shaliulab/idoc_docs/README.md

IDOC DOCS

To spawn the docs locally:

```
mkdocs serve
```

# In Ubuntu Linux, if you don't have mkdocs

```
sudo apt install mkdocs
```
