shaliulab/idoc_docs/docs/assets/src/Design_Files_LED_Driver_.01/README.md

LED_Driver V.01 

Currently, we have not shared the LED-driver designs, but please get in contact if you need further information.
