shaliulab/idoc_docs/docs/assets/src/ElectricShock/README.md

Currently, we have not shared the electric shock grid designs on the transparent induim tin oxid (ITO) glass slides, but please get in contact if you need further information.
