shaliulab/idoc_docs/docs/assets/Images/20220316_103206.jpg

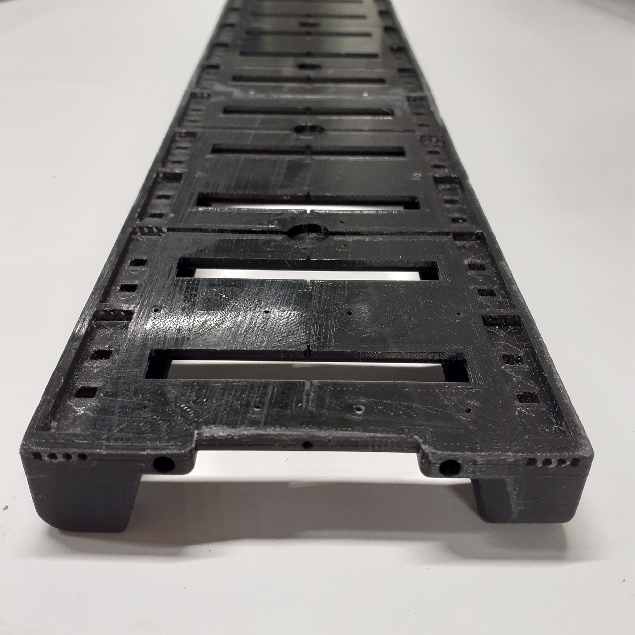
docs/assets/Images/20220316_103206.jpg
