shaliulab/idoc_docs/docs/assets/Images/20220316_135914.jpg

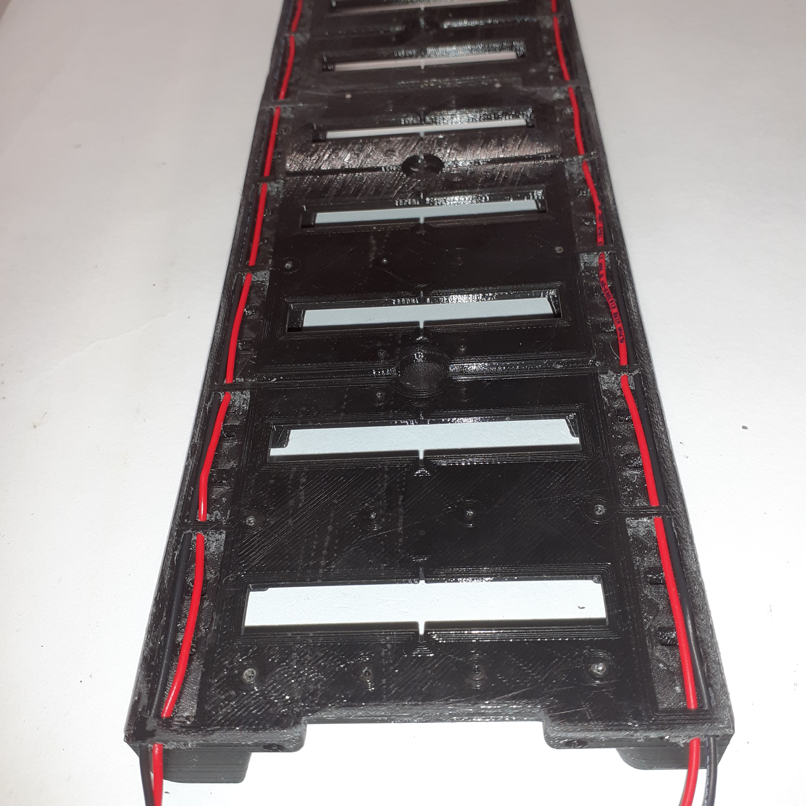
docs/assets/Images/20220316_135914.jpg
