shaliulab/idoc_docs/docs/assets/Images/20220321_164638.jpg

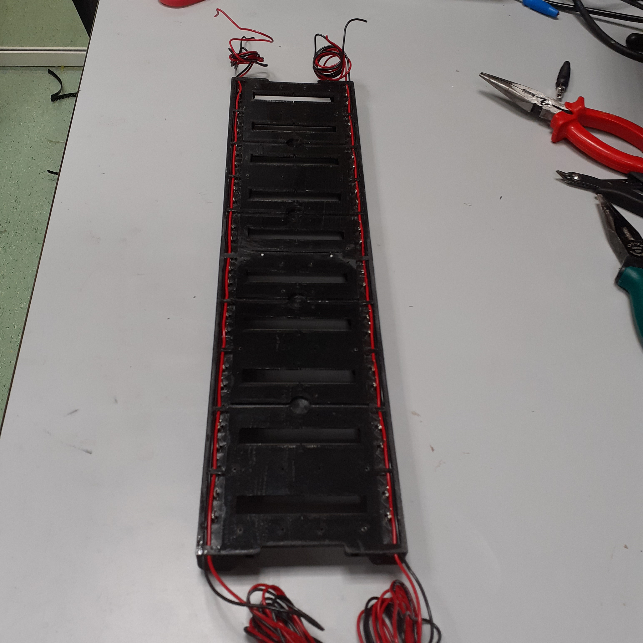
docs/assets/Images/20220321_164638.jpg
