shaliulab/idoc_docs/docs/assets/Images/chamber-tray-real.jpg

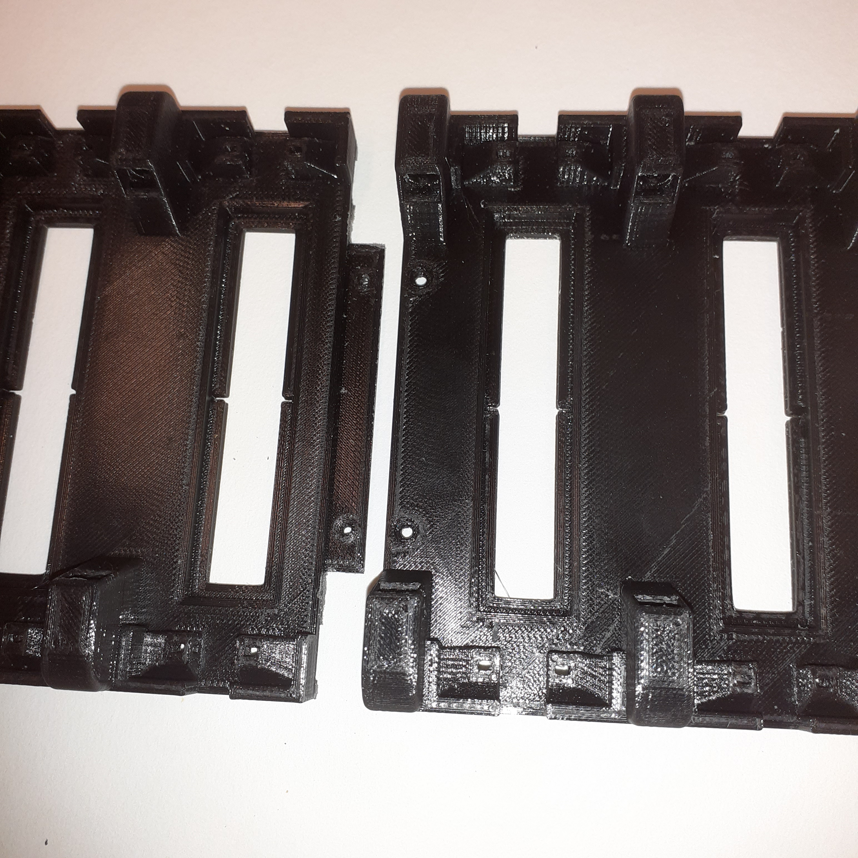
docs/assets/Images/chamber-tray-real.jpg
