shaliulab/idoc_docs/docs/assets/Images/chamber-tray-superglue.jpg

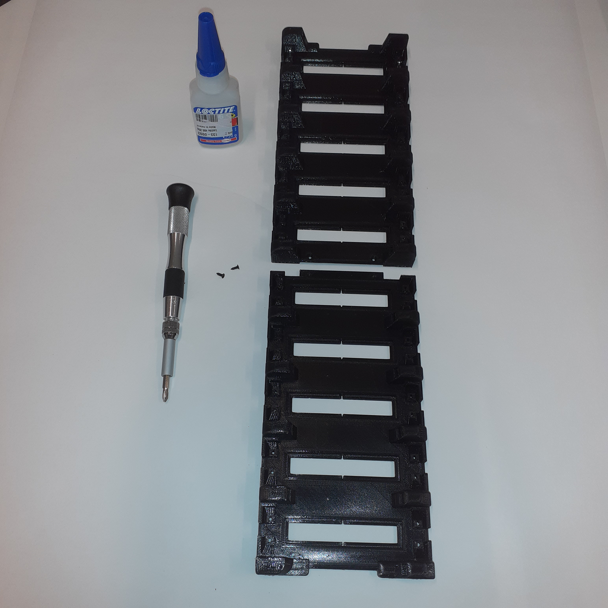
docs/assets/Images/chamber-tray-superglue.jpg
