shaliulab/idoc_docs/docs/assets/Images/idoc_cli-menu.jpg

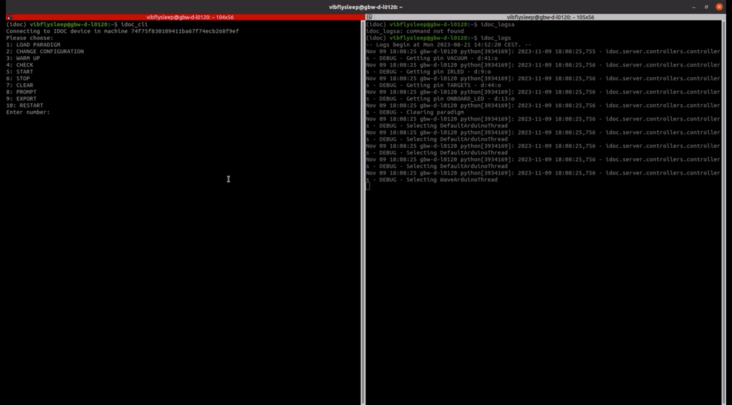
docs/assets/Images/idoc_cli-menu.jpg
