shaliulab/idoc_docs/docs/assets/Images/tracking_dots_annotated.png

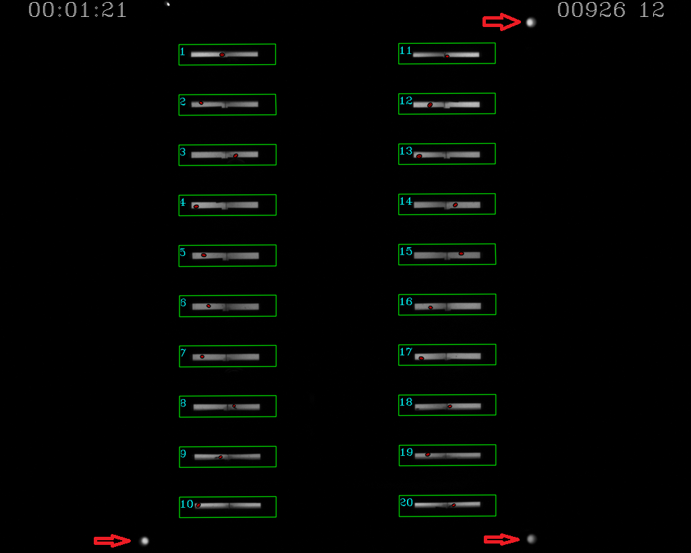
docs/assets/Images/tracking_dots_annotated.png
