shaliulab/idoc_docs/docs/assets/src/3D_printed_parts/Recording_chambers/README.md

Currently, we have not shared the chamber 3D-designs, but please get in contact if you need further information.

We have developed the following designs:

- Chamber_with- ITO_glass --> to provide the electric shocks during training.
- Chamber_ Non ITO_glass--> to be used for pre- and post- conditioning  testing.
- Chamber_Heater_glass --> to provide an increase in the temperature while testing.
- Chamber_saving_rack.

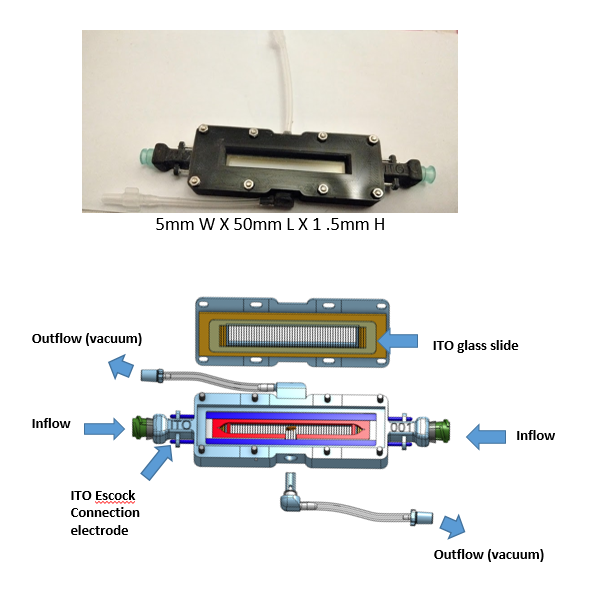
[picture p9: docs/assets/Images/IDOC-Chamber.PNG]
