shaliulab/idoc_docs/docs/IDOC_3D_Assembly_Parts.pdf

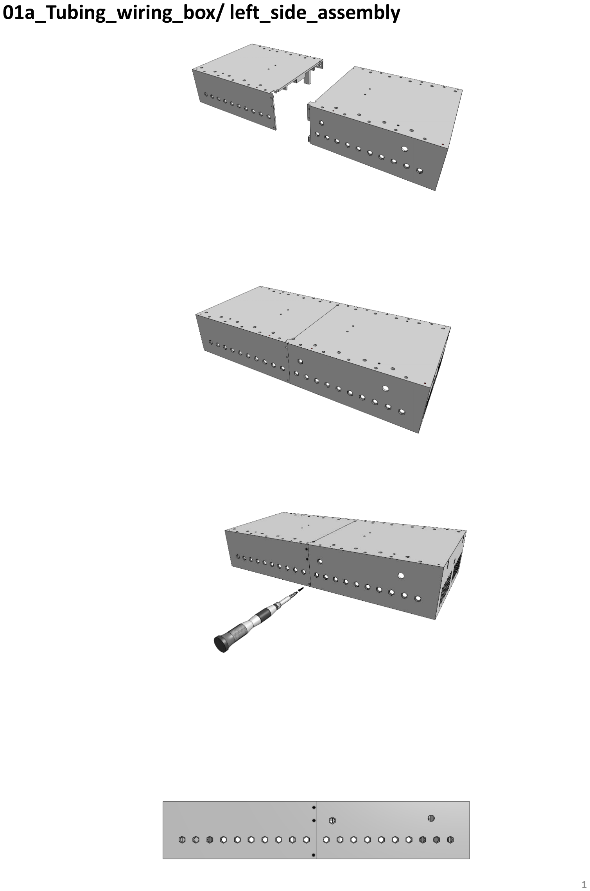
[picture p121: page 1]

01a_Tubing_wiring_box/ left_side_assembly

1

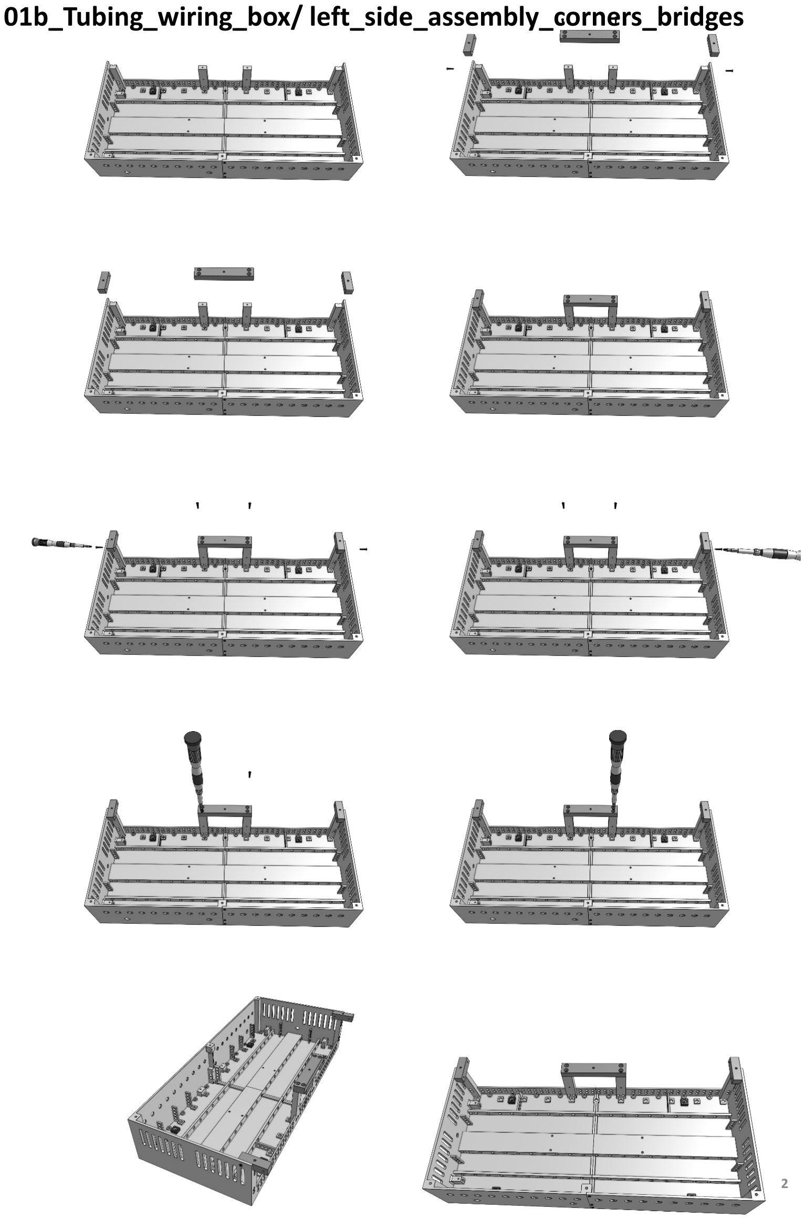
[picture p122: page 2]

01b_Tubing_wiring_box/ left_side_assembly_corners_bridges

2

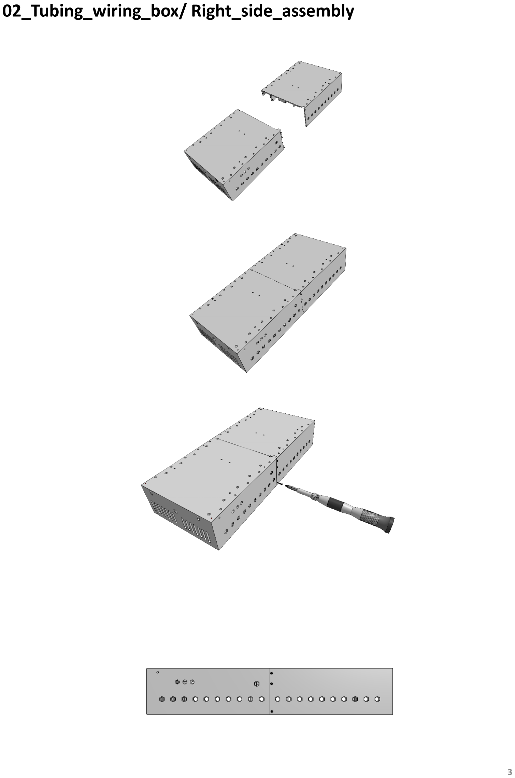
[picture p123: page 3]

02_Tubing_wiring_box/ Right_side_assembly

3

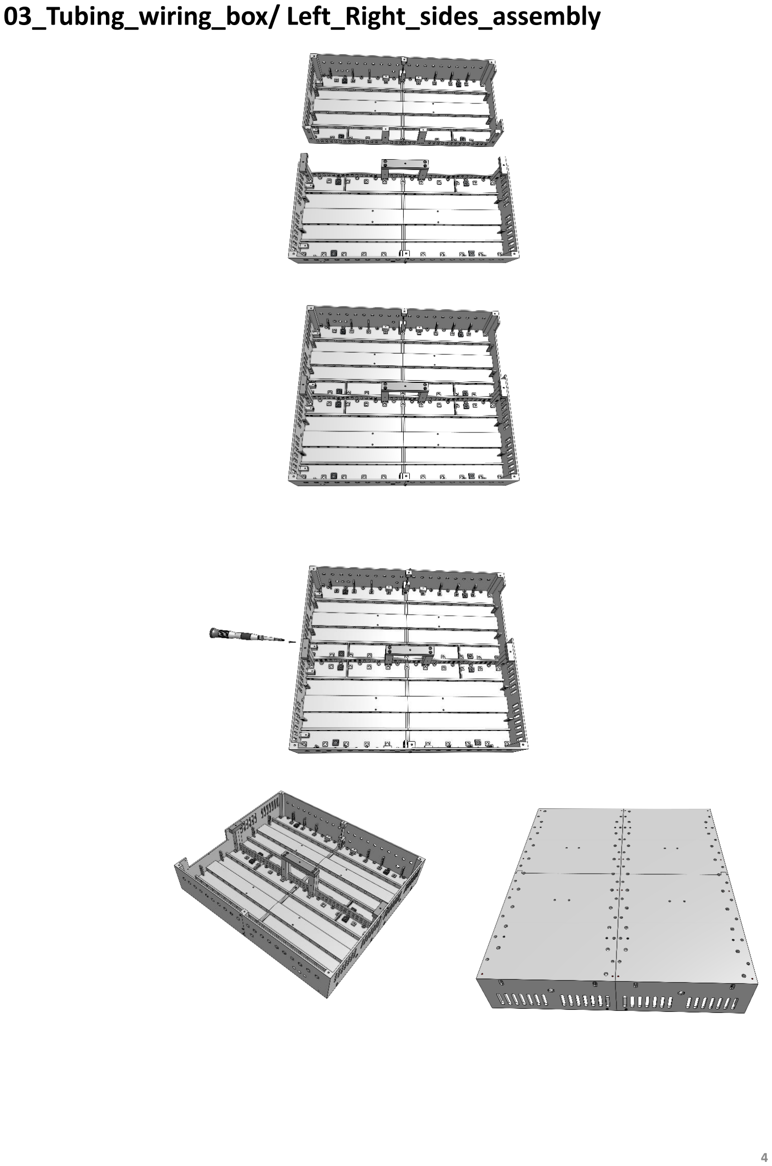
[picture p124: page 4]

03_Tubing_wiring_box/ Left_Right_sides_assembly

4

04a_Inflow_tubings_collectors_Right&Left

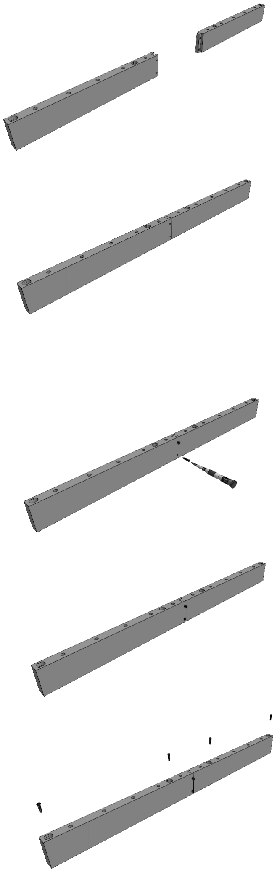
[picture p125: figure]

5

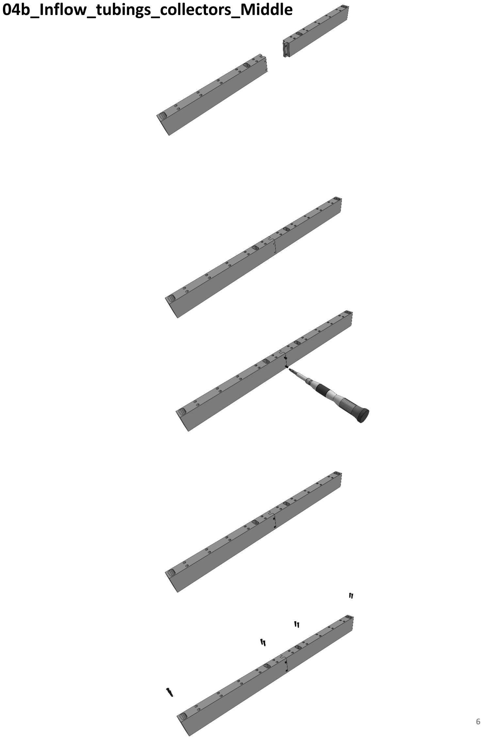
[picture p126: page 6]

04b_Inflow_tubings_collectors_Middle

6

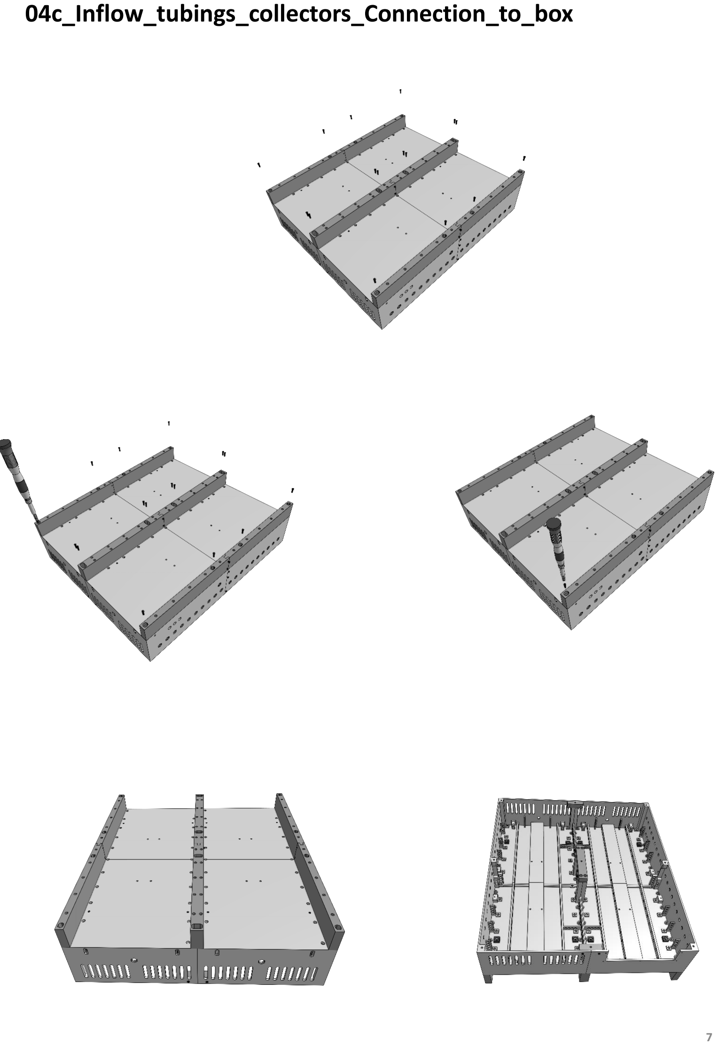
[picture p127: page 7]

04c_Inflow_tubings_collectors_Connection_to_box

7

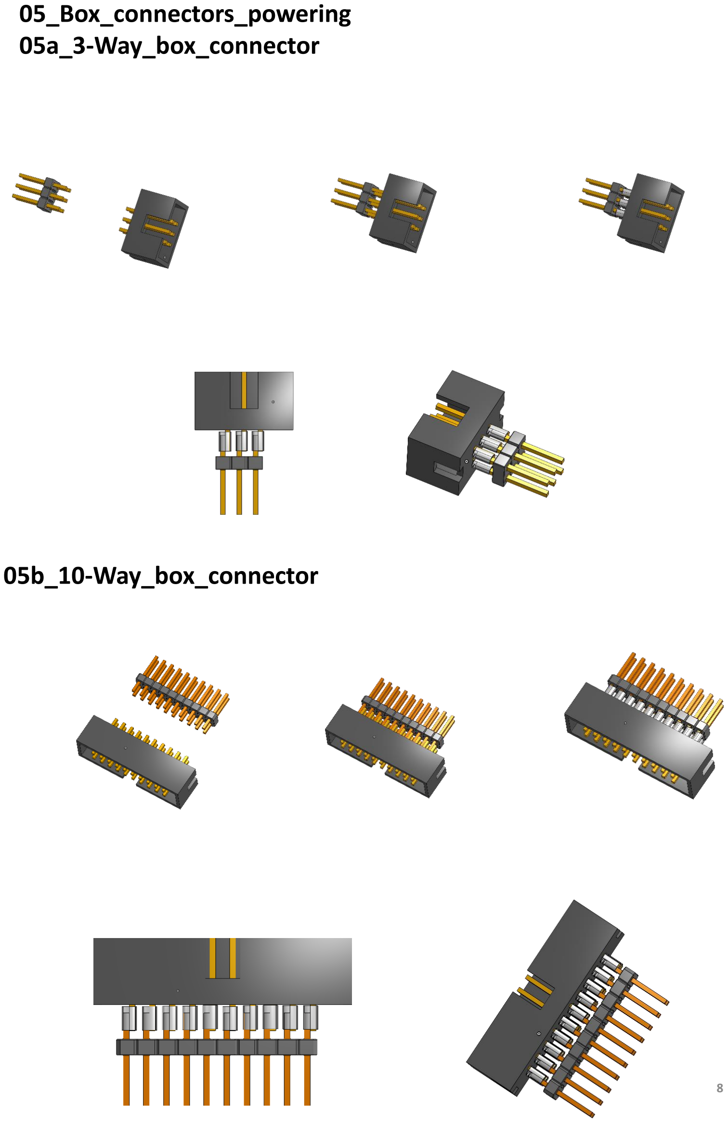
[picture p128: page 8]

05_Box_connectors_powering 05a_3-Way_box_connector

05b_10-Way_box_connector

8

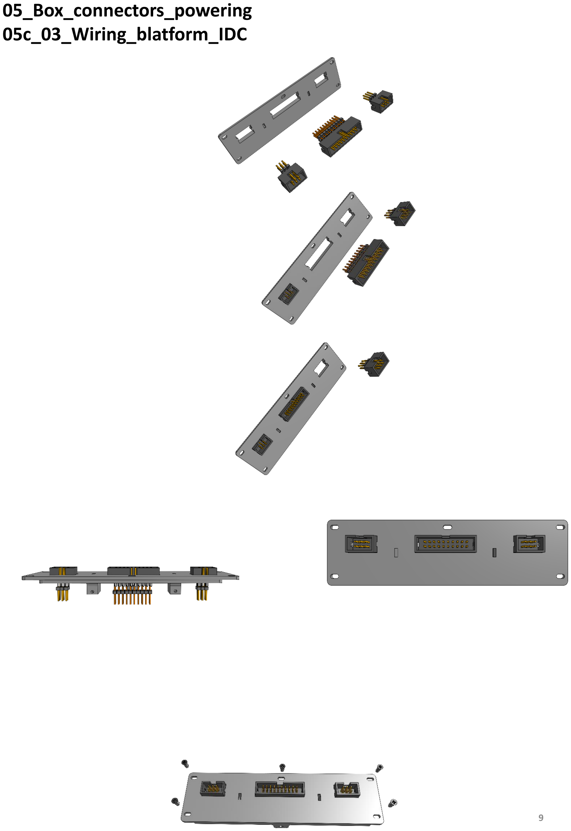
[picture p129: page 9]

05_Box_connectors_powering 05c_03_Wiring_blatform_IDC

9

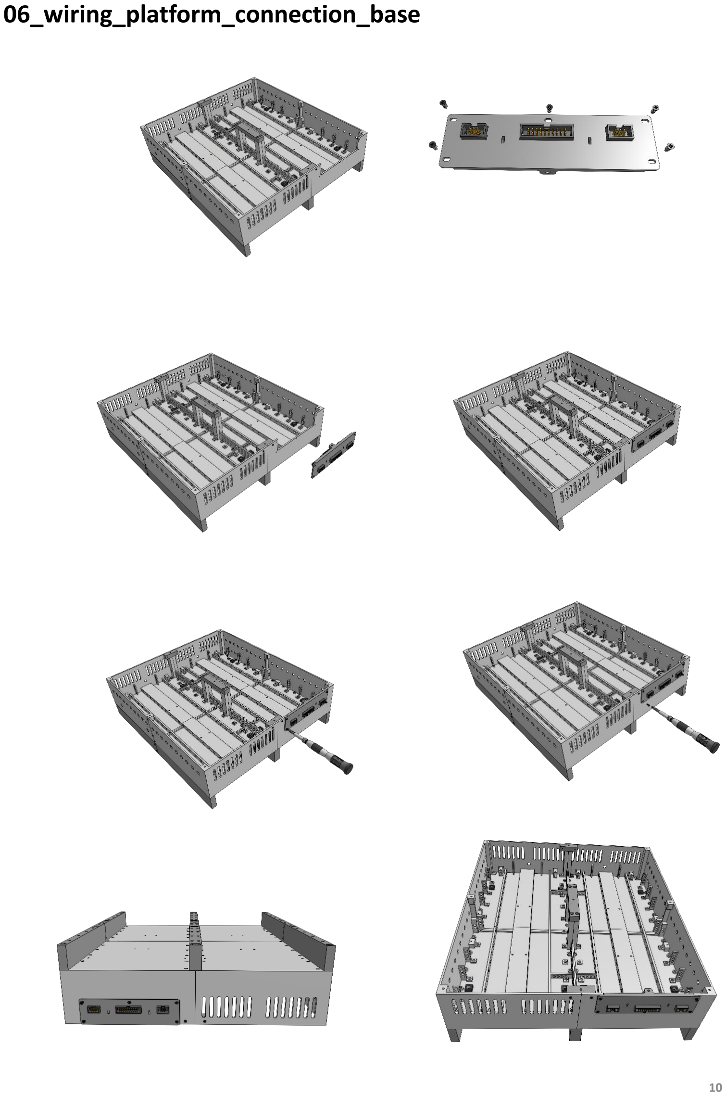
[picture p130: page 10]

06_wiring_platform_connection_base

10

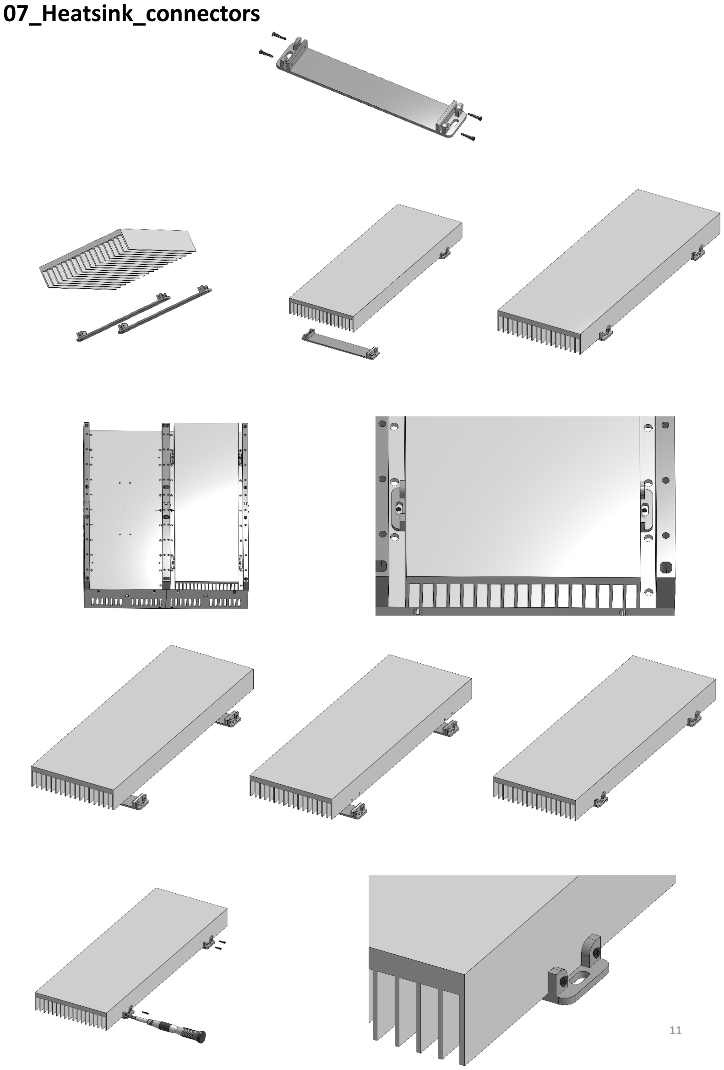
[picture p131: page 11]

07_Heatsink_connectors

11

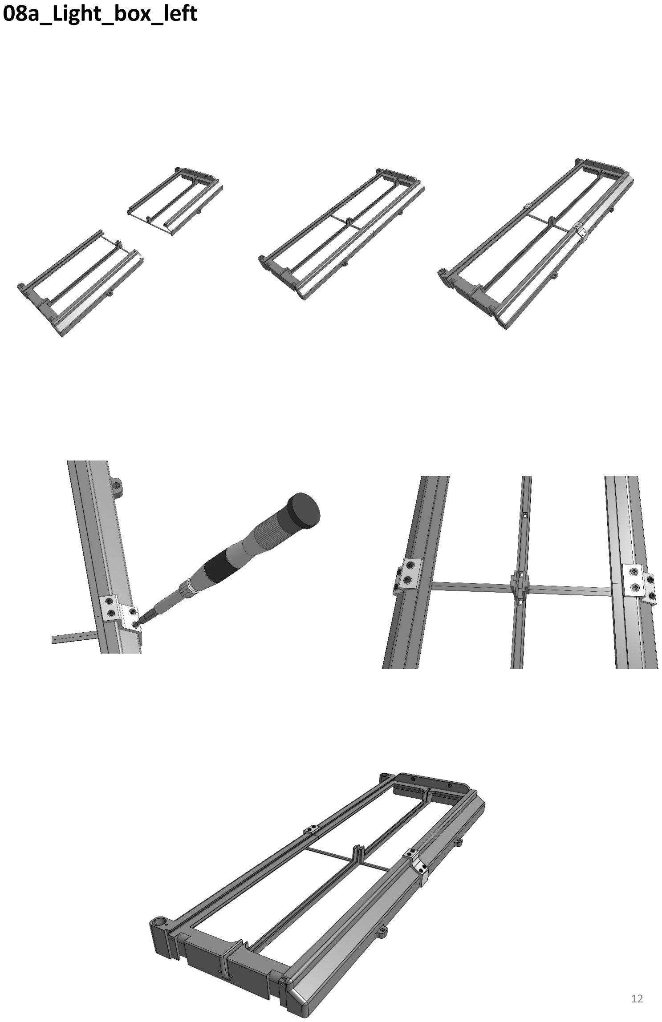
[picture p132: page 12]

08a_Light_box_left

12

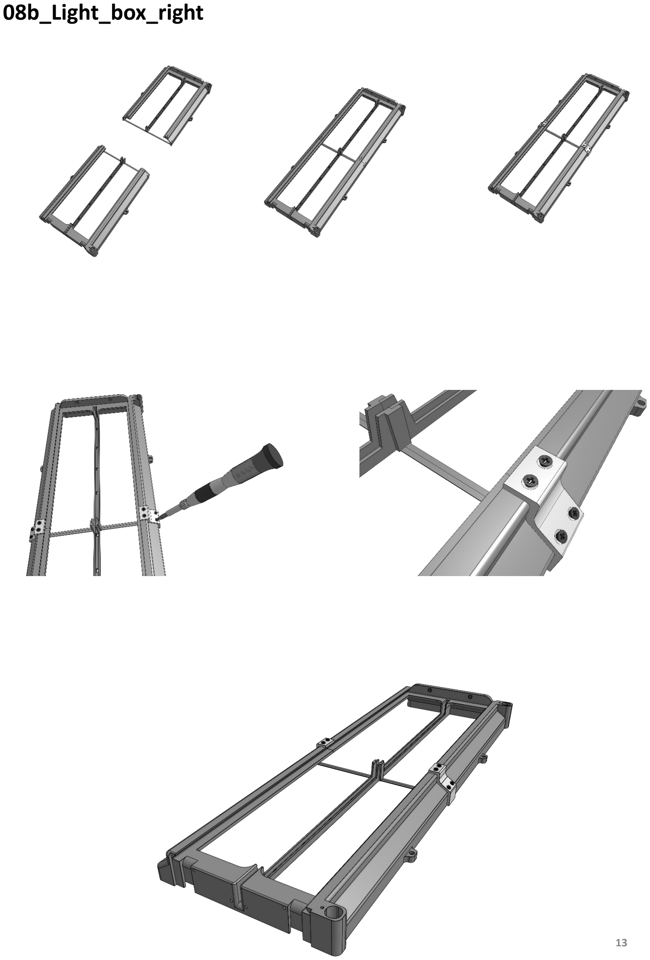
[picture p133: page 13]

08b_Light_box_right

13

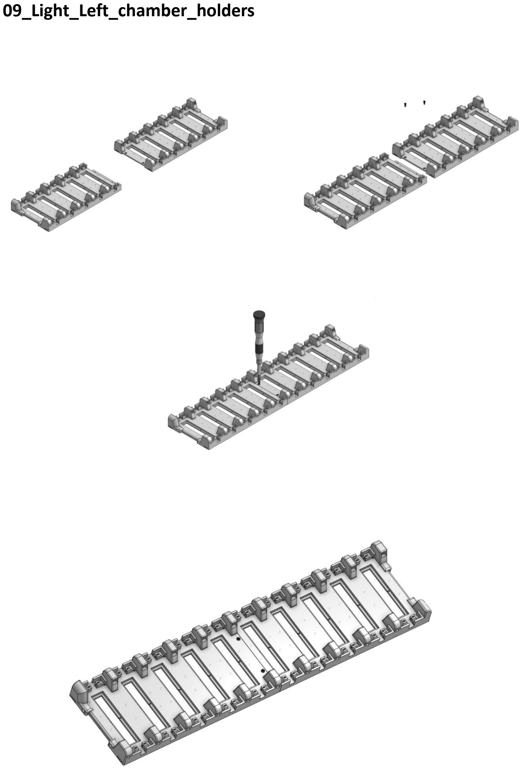
[picture p134: page 14]

09_Light_Left_chamber_holders
