shaliulab/idoc_docs/docs/assets/src/3D_printed_parts/Air_inflow_outflow_olfaction_system/main valve holder - Main_valve_holder.stl

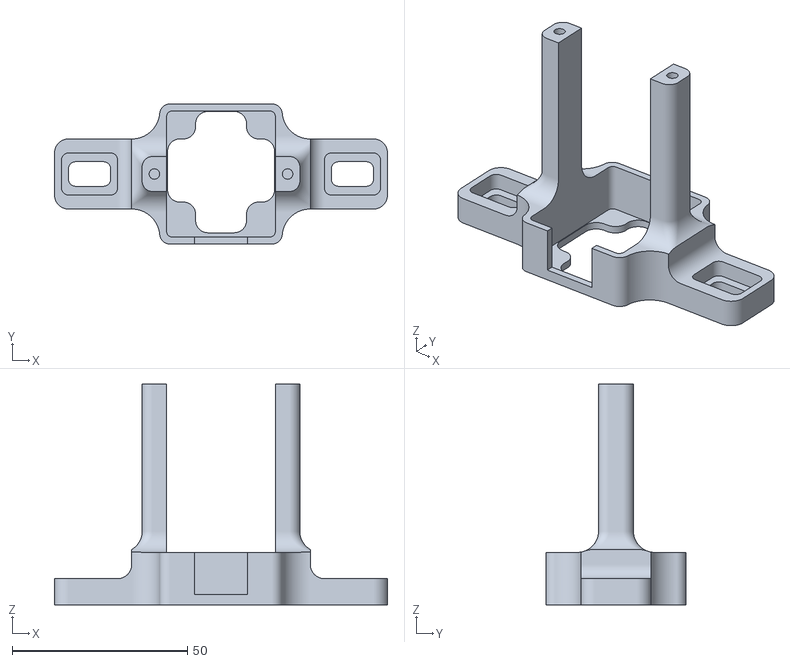
[picture p135: CAD file, 2022-08-08]
docs/assets/src/3D_printed_parts/Air_inflow_outflow_olfaction_system/main valve holder - Main_valve_holder.stl
95.0 x 40.0 x 63.0
