shaliulab/idoc_docs/docs/assets/src/3D_printed_parts/Air_inflow_outflow_olfaction_system/main valve holder - Valve_Locker.stl

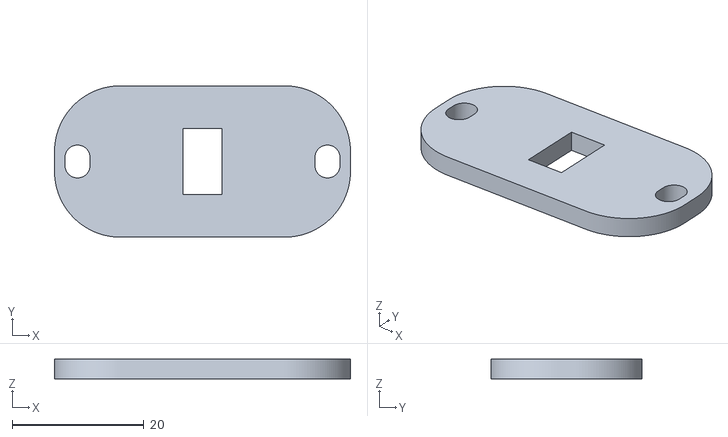
[picture p136: CAD file, 2022-08-08]
docs/assets/src/3D_printed_parts/Air_inflow_outflow_olfaction_system/main valve holder - Valve_Locker.stl
45.0 x 23.0 x 3.00
