shaliulab/idoc_docs/docs/assets/src/3D_printed_parts/100ml-mineral-oil-bottle-holders/100 ml bottle holders Bottom - white_background.stl

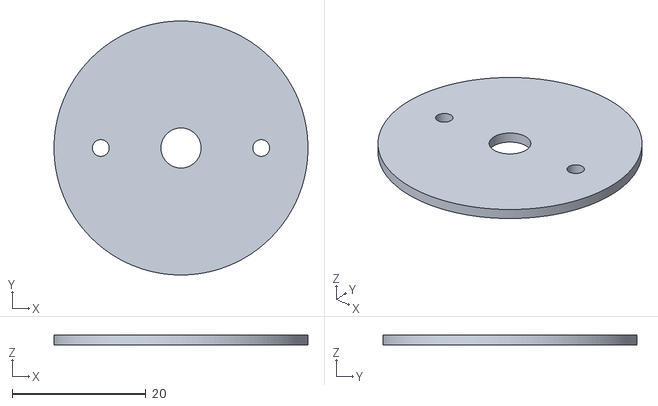
[picture p137: CAD file, 2022-08-08]
docs/assets/src/3D_printed_parts/100ml-mineral-oil-bottle-holders/100 ml bottle holders Bottom - white_background.stl
38.0 x 38.0 x 1.50
