shaliulab/idoc_docs/docs/assets/src/3D_printed_parts/Air_inflow_outflow_olfaction_system/tubes collection.stl

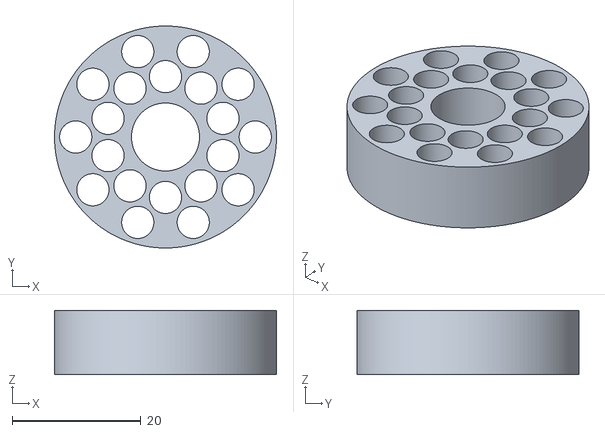
[picture p138: CAD file, 2022-08-08]
docs/assets/src/3D_printed_parts/Air_inflow_outflow_olfaction_system/tubes collection.stl
34.5 x 34.5 x 10.0
