shaliulab/idoc_docs/docs/assets/src/3D_printed_parts/Arduion-control-unit/Arduino_relay_board_BACK.stl

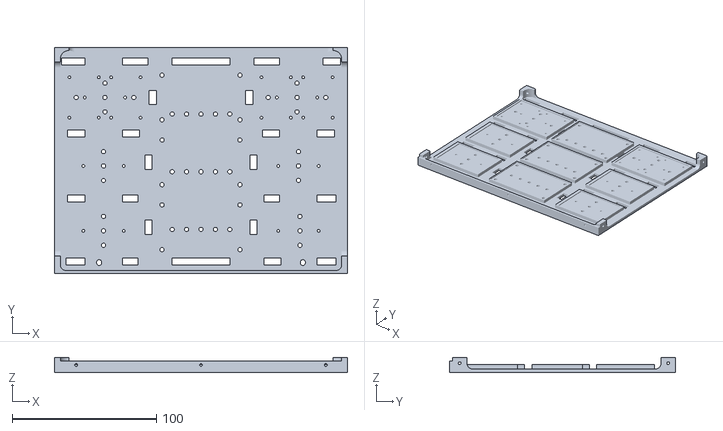
[picture p139: CAD file, 2022-08-08]
docs/assets/src/3D_printed_parts/Arduion-control-unit/Arduino_relay_board_BACK.stl
203.2 x 156.6 x 10.5
