shaliulab/idoc_docs/docs/assets/src/3D_printed_parts/Enclosure&Powering/25-mm_mounting_constructions/Elbow_L-shape_door_connection.stl

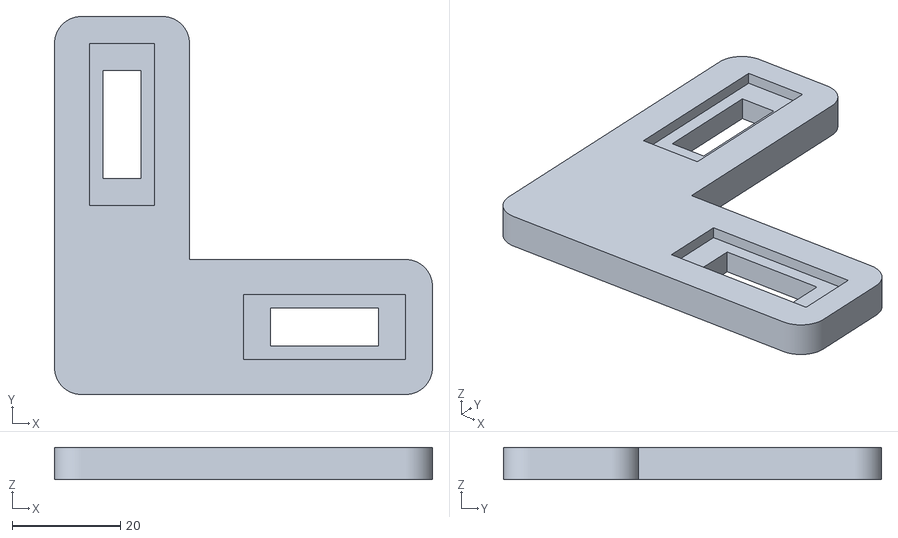
[picture p140: CAD file, 2022-08-08]
docs/assets/src/3D_printed_parts/Enclosure&Powering/25-mm_mounting_constructions/Elbow_L-shape_door_connection.stl
70.0 x 70.0 x 6.00
