shaliulab/idoc_docs/docs/assets/src/3D_printed_parts/Enclosure&Powering/Holes_backside_enclosure/Powering_panels/Bottom_left_panel/Outside_box_cover_bottom_powering_panel_part_3_of_3.stl

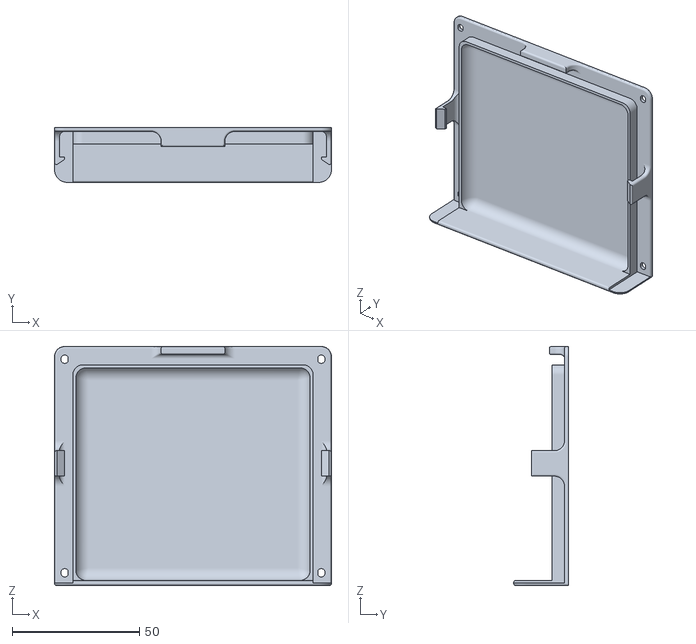
[picture p141: CAD file, 2022-08-08]
docs/assets/src/3D_printed_parts/Enclosure&Powering/Holes_backside_enclosure/Powering_panels/Bottom_left_panel/Outside_box_cover_bottom_powering_panel_part_3_of_3.stl
108.8 x 21.5 x 93.9
