shaliulab/idoc_docs/docs/assets/src/3D_printed_parts/Enclosure&Powering/Holes_backside_enclosure/Powering_panels/Top_right_and_left_panel/IDC_CONNECTOR_GREEN_LEDs_top_powering_panel_part_1_of_3.stl

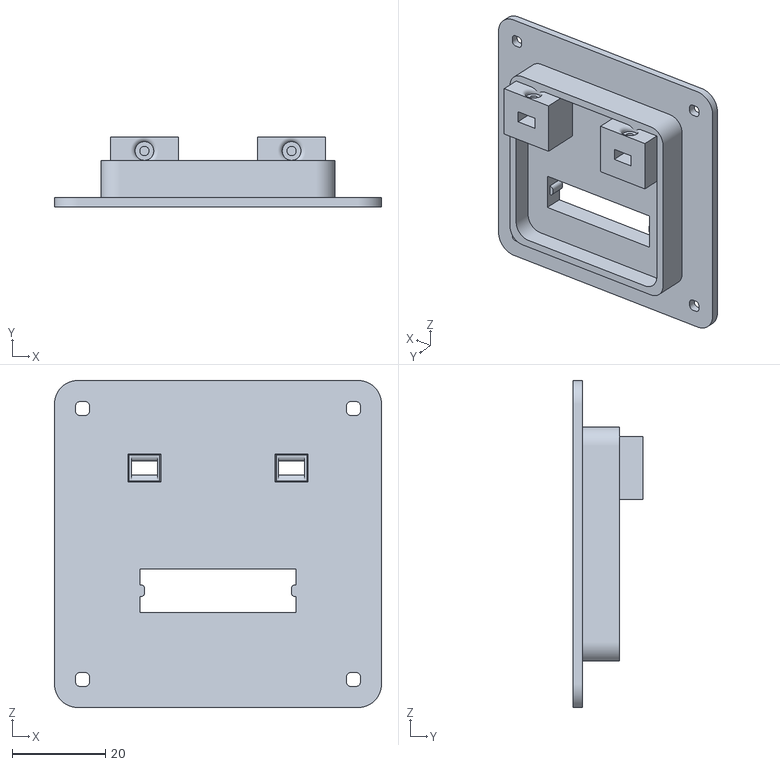
[picture p142: CAD file, 2022-08-08]
docs/assets/src/3D_printed_parts/Enclosure&Powering/Holes_backside_enclosure/Powering_panels/Top_right_and_left_panel/IDC_CONNECTOR_GREEN_LEDs_top_powering_panel_part_1_of_3.stl
70.0 x 15.0 x 70.0
