shaliulab/idoc_docs/docs/assets/src/3D_printed_parts/Enclosure&Powering/Roof_IR_Sheet_holder/IR_sheet_holder_roof_fixation_LED_light_stripe_inside_part_1_of_2.stl

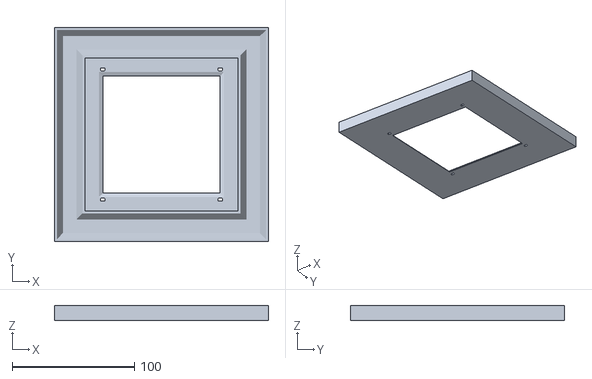
[picture p143: CAD file, 2022-08-08]
docs/assets/src/3D_printed_parts/Enclosure&Powering/Roof_IR_Sheet_holder/IR_sheet_holder_roof_fixation_LED_light_stripe_inside_part_1_of_2.stl
175.0 x 175.0 x 12.0
