shaliulab/idoc_docs/docs/assets/src/3D_printed_parts/Enclosure&Powering/Two_side_connection_IDC_cables/two_side_connection - cover.stl

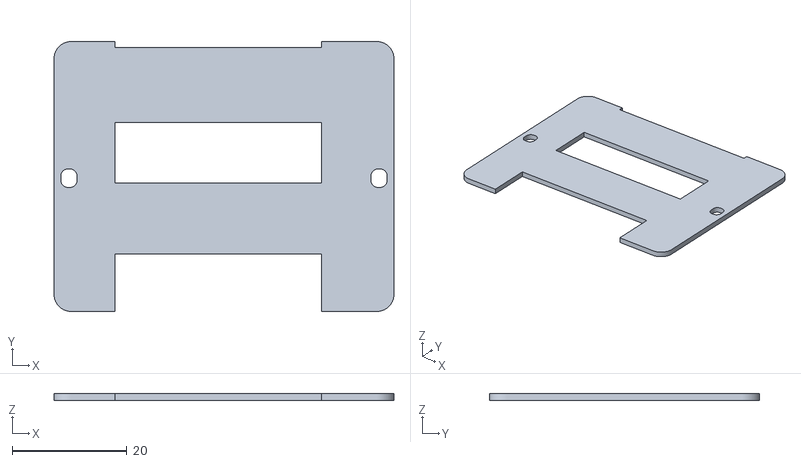
[picture p144: CAD file, 2022-08-08]
docs/assets/src/3D_printed_parts/Enclosure&Powering/Two_side_connection_IDC_cables/two_side_connection - cover.stl
59.2 x 47.0 x 1.20
