shaliulab/idoc_docs/docs/assets/src/3D_printed_parts/Green_light_panel/Green_light_panel - Heat_sink.stl

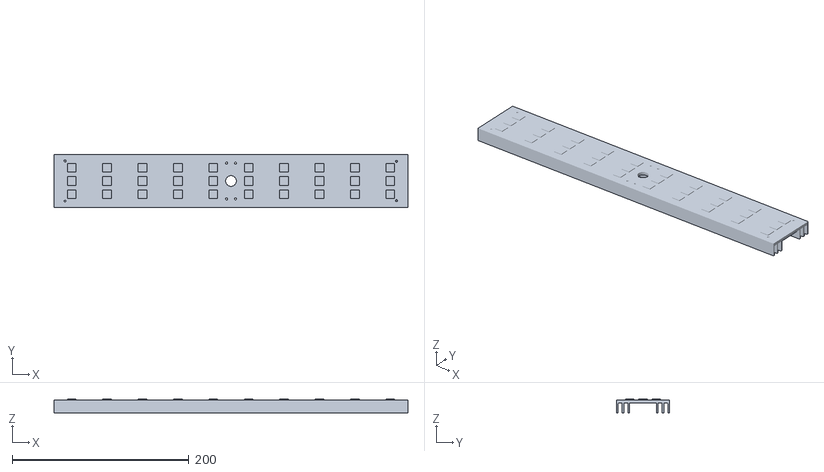
[picture p145: CAD file, 2022-08-08]
docs/assets/src/3D_printed_parts/Green_light_panel/Green_light_panel - Heat_sink.stl
400.0 x 60.0 x 16.0
