shaliulab/idoc_docs/docs/assets/src/3D_printed_parts/IDOC_setup/030_3D_Light_box_LEFT_BACK_01.stl

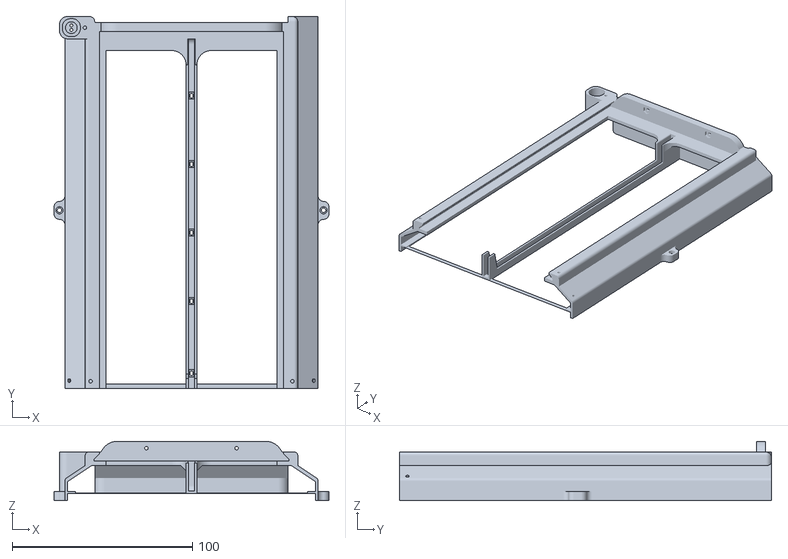
[picture p146: CAD file, 2022-08-08]
docs/assets/src/3D_printed_parts/IDOC_setup/030_3D_Light_box_LEFT_BACK_01.stl
152.5 x 206.4 x 33.0
