shaliulab/idoc_docs/docs/assets/src/3D_printed_parts/IR_sheet_cutter/IR sheet cutter - Part 1.stl

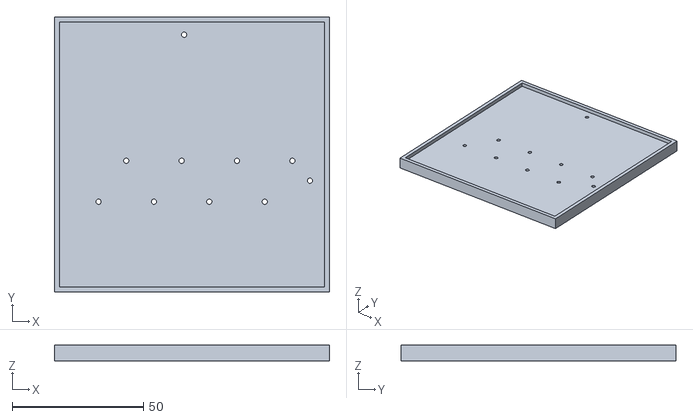
[picture p147: CAD file, 2022-08-08]
docs/assets/src/3D_printed_parts/IR_sheet_cutter/IR sheet cutter - Part 1.stl
104.8 x 104.8 x 6.00
