shaliulab/idoc_docs/docs/assets/src/3D_printed_parts/Recording_chambers/Chamber-inner_chamber.stl

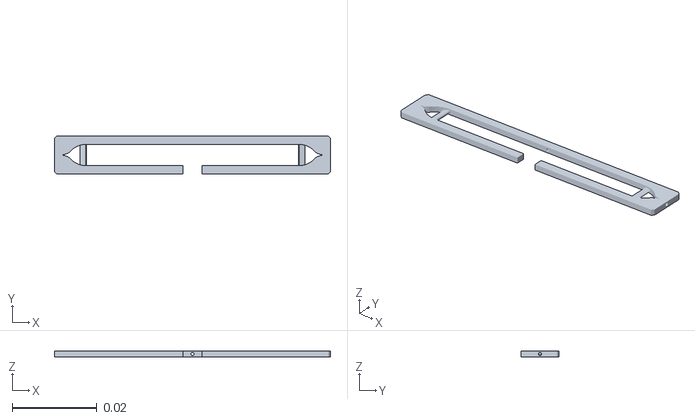
[picture p148: CAD file, 2024-10-31]
docs/assets/src/3D_printed_parts/Recording_chambers/Chamber-inner_chamber.stl
0.065 x 0.009 x 0.0013
