shaliulab/idoc_docs/docs/assets/src/3D_printed_parts/100ml-mineral-oil-bottle-holders/100 ml bottle holders Bottom - Base.stl

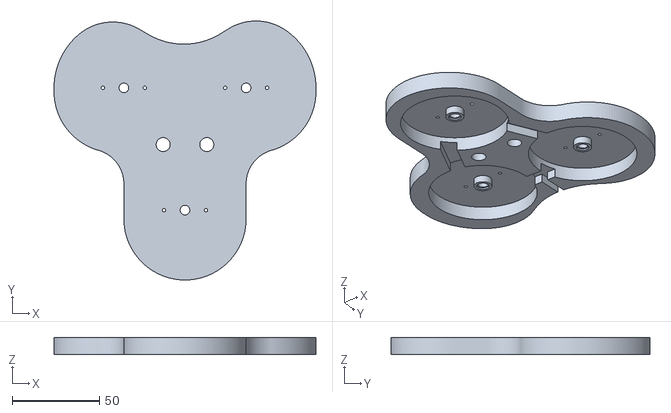
[picture p149: CAD file, 2022-08-08]
docs/assets/src/3D_printed_parts/100ml-mineral-oil-bottle-holders/100 ml bottle holders Bottom - Base.stl
150.0 x 148.3 x 10.0
