shaliulab/idoc_docs/docs/assets/src/3D_printed_parts/Air_inflow_outflow_olfaction_system/Flowmeter_holder_double - flowmeter hoder.stl

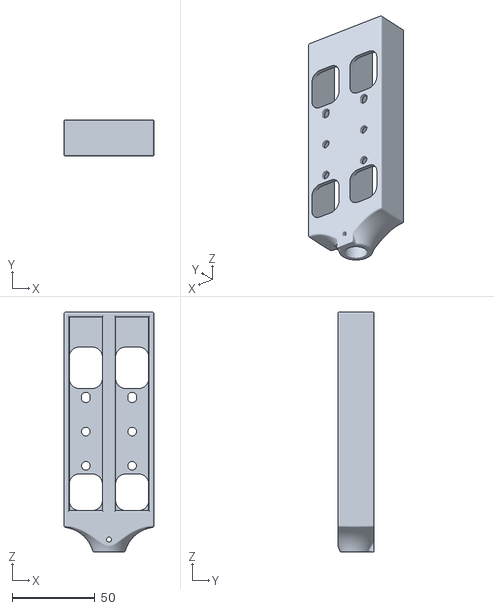
[picture p150: CAD file, 2022-08-08]
docs/assets/src/3D_printed_parts/Air_inflow_outflow_olfaction_system/Flowmeter_holder_double - flowmeter hoder.stl
54.4 x 22.0 x 145.0
