shaliulab/idoc_docs/docs/assets/src/3D_printed_parts/Arduion-control-unit/Board_connection.stl

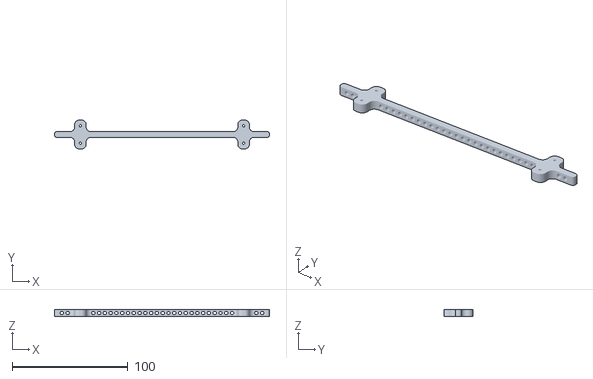
[picture p151: CAD file, 2022-08-08]
docs/assets/src/3D_printed_parts/Arduion-control-unit/Board_connection.stl
186.0 x 25.0 x 6.00
