shaliulab/idoc_docs/docs/assets/src/3D_printed_parts/Enclosure&Powering/25-mm_mounting_constructions/Construction_cube_with_slotted_channel_door_connection_universal.stl

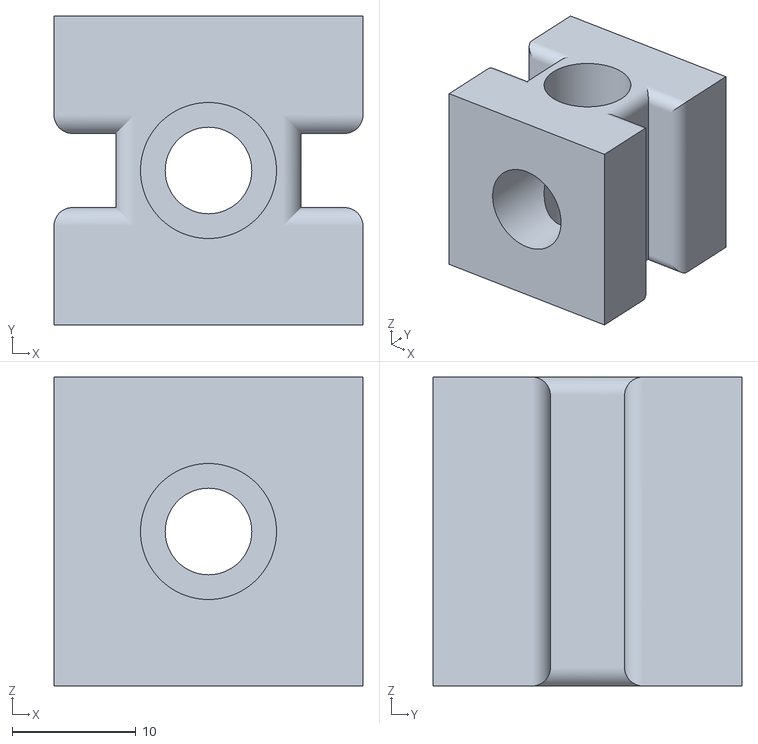
[picture p152: CAD file, 2022-08-08]
docs/assets/src/3D_printed_parts/Enclosure&Powering/25-mm_mounting_constructions/Construction_cube_with_slotted_channel_door_connection_universal.stl
25.0 x 25.0 x 25.0
