shaliulab/idoc_docs/docs/assets/src/3D_printed_parts/Enclosure&Powering/Holes_backside_enclosure/Powering_panels/Bottom_left_panel/IDC_RED_BLUE_LEDs_IIndicators_LEFT_powering_panel_part_1_of_3.stl

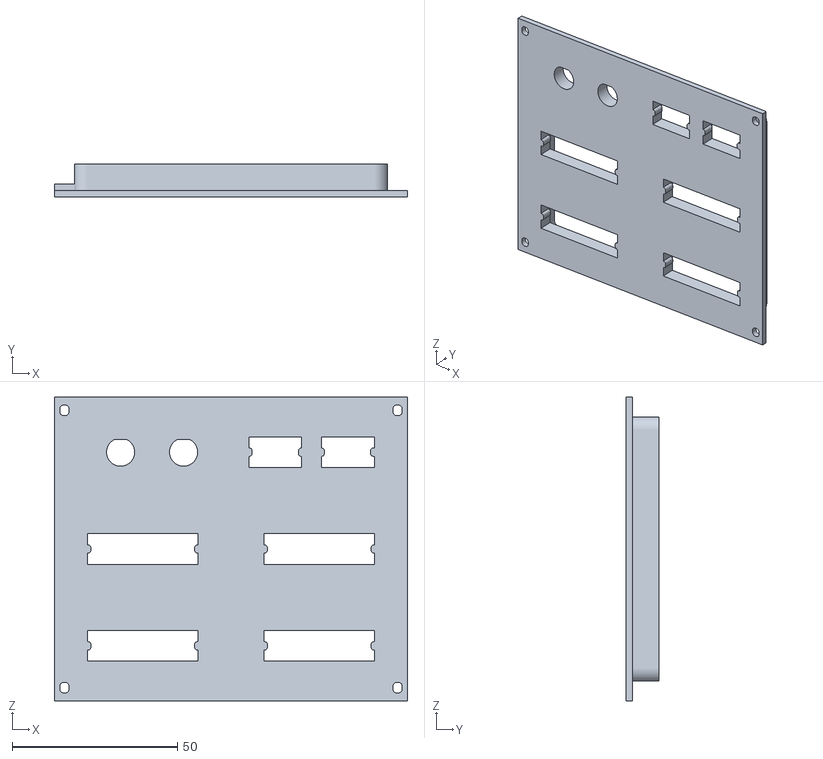
[picture p153: CAD file, 2022-08-08]
docs/assets/src/3D_printed_parts/Enclosure&Powering/Holes_backside_enclosure/Powering_panels/Bottom_left_panel/IDC_RED_BLUE_LEDs_IIndicators_LEFT_powering_panel_part_1_of_3.stl
106.8 x 10.0 x 91.9
