shaliulab/idoc_docs/docs/assets/src/3D_printed_parts/Enclosure&Powering/Holes_backside_enclosure/Powering_panels/Bottom_right_panel/Ouside_fixation_box_bottom_powering_panel_part_2_of_3.stl

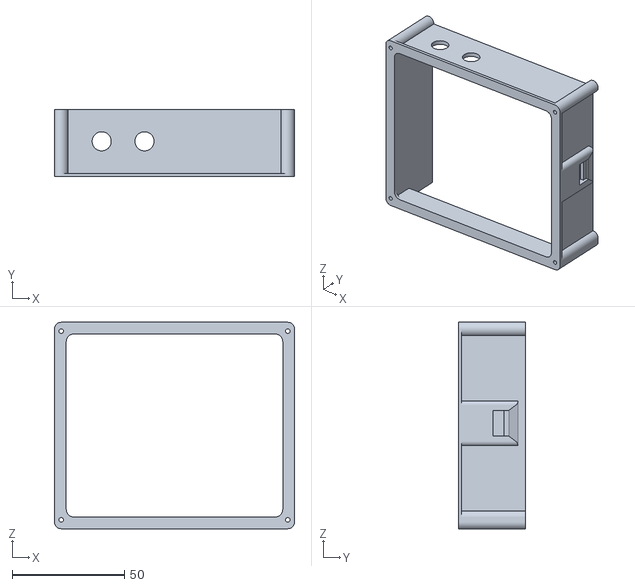
[picture p154: CAD file, 2022-08-08]
docs/assets/src/3D_printed_parts/Enclosure&Powering/Holes_backside_enclosure/Powering_panels/Bottom_right_panel/Ouside_fixation_box_bottom_powering_panel_part_2_of_3.stl
106.8 x 30.0 x 91.9
