shaliulab/idoc_docs/docs/assets/src/3D_printed_parts/Enclosure&Powering/Holes_backside_enclosure/Powering_panels/Top_right_and_left_panel/Outside_box_cover_top_powering_panel__part_1_of_3.stl

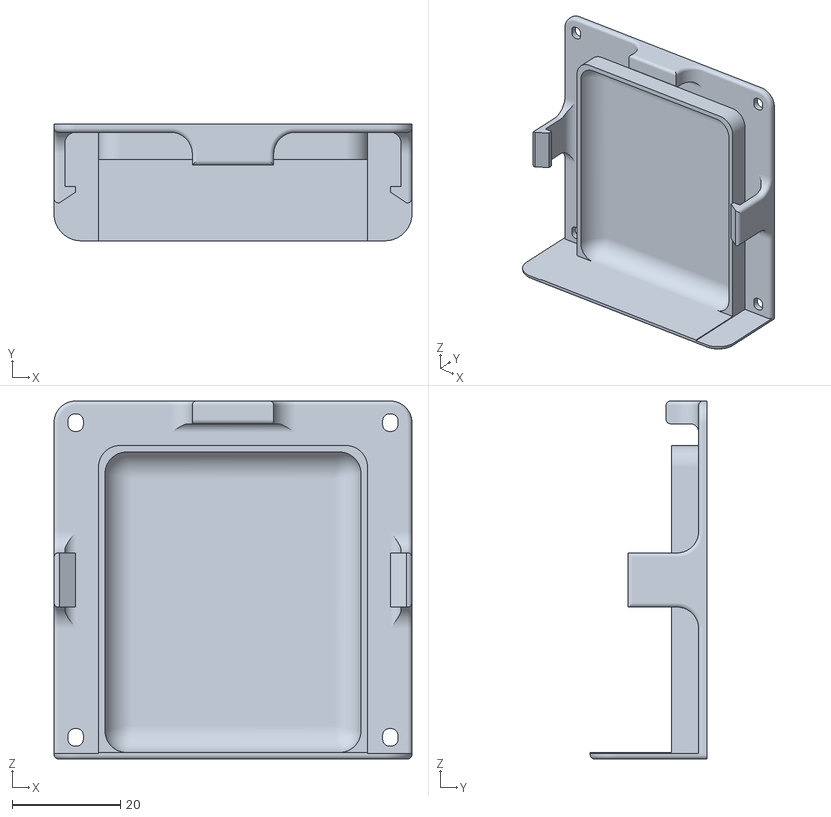
[picture p155: CAD file, 2022-08-08]
docs/assets/src/3D_printed_parts/Enclosure&Powering/Holes_backside_enclosure/Powering_panels/Top_right_and_left_panel/Outside_box_cover_top_powering_panel__part_1_of_3.stl
66.0 x 21.5 x 66.0
