shaliulab/idoc_docs/docs/assets/src/3D_printed_parts/Enclosure&Powering/Roof_IR_Sheet_holder/IR_sheet_holder_roof_fixation_LEE_filter_ouside_part_2_of_2.stl

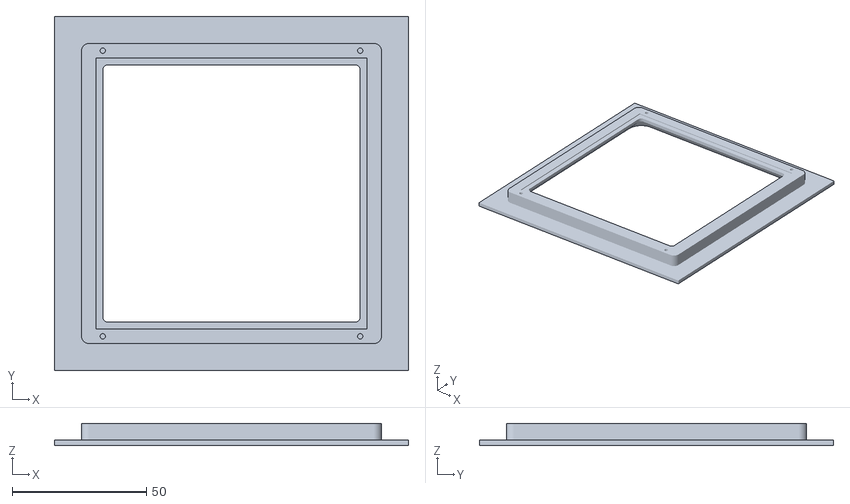
[picture p156: CAD file, 2022-08-08]
docs/assets/src/3D_printed_parts/Enclosure&Powering/Roof_IR_Sheet_holder/IR_sheet_holder_roof_fixation_LEE_filter_ouside_part_2_of_2.stl
132.0 x 132.0 x 8.26
