shaliulab/idoc_docs/docs/assets/src/3D_printed_parts/Enclosure&Powering/Two_side_connection_IDC_cables/two_side_connection - Box.stl

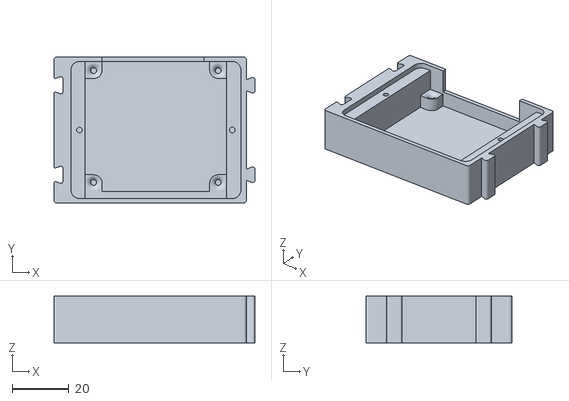
[picture p157: CAD file, 2022-08-08]
docs/assets/src/3D_printed_parts/Enclosure&Powering/Two_side_connection_IDC_cables/two_side_connection - Box.stl
71.0 x 51.6 x 16.5
