shaliulab/idoc_docs/docs/assets/src/3D_printed_parts/Green_light_panel/Green_light_panel - Cover_holder_wall_LEFT.stl

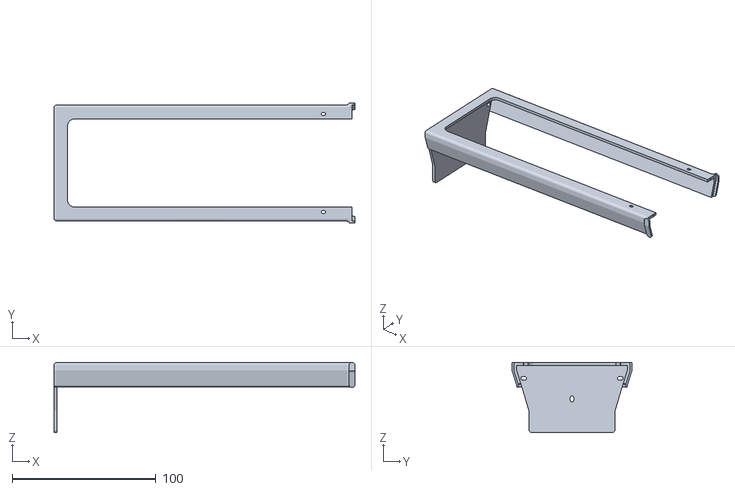
[picture p158: CAD file, 2022-08-08]
docs/assets/src/3D_printed_parts/Green_light_panel/Green_light_panel - Cover_holder_wall_LEFT.stl
209.4 x 83.3 x 48.8
