shaliulab/idoc_docs/docs/assets/src/3D_printed_parts/IDOC_setup/010-3D_Inflow_tubes_collector_FRONT_LEFT_01B.stl

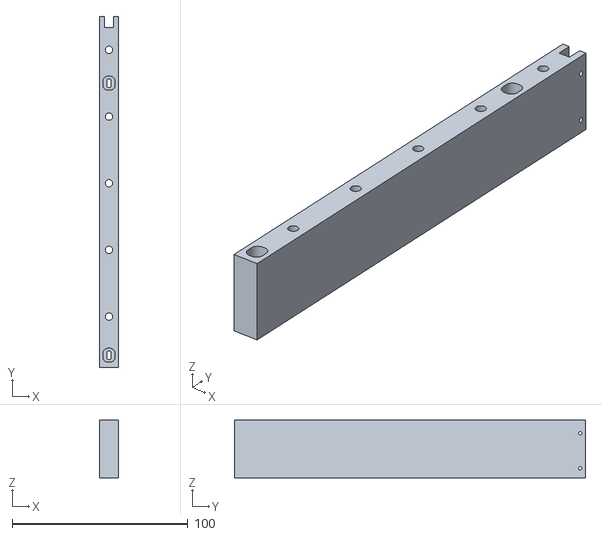
[picture p159: CAD file, 2022-08-08]
docs/assets/src/3D_printed_parts/IDOC_setup/010-3D_Inflow_tubes_collector_FRONT_LEFT_01B.stl
11.0 x 200.0 x 33.0
