shaliulab/idoc_docs/docs/assets/src/3D_printed_parts/Recording_chambers/Rubber_cut-Base_template_piece.stl

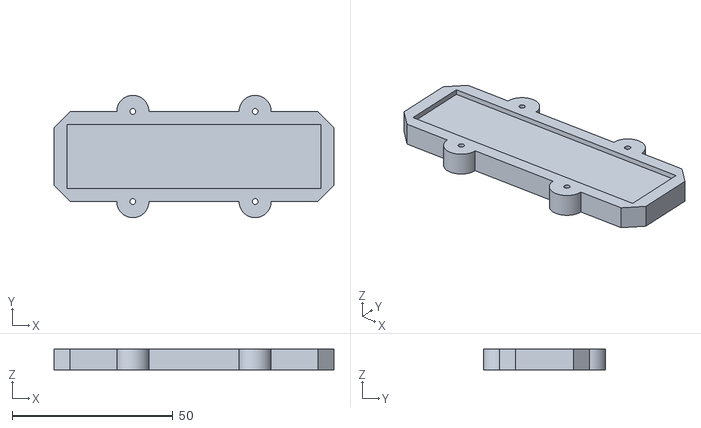
[picture p160: CAD file, 2024-10-31]
docs/assets/src/3D_printed_parts/Recording_chambers/Rubber_cut-Base_template_piece.stl
87.0 x 38.0 x 6.50
