shaliulab/idoc_docs/docs/assets/src/3D_printed_parts/Enclosure&Powering/25-mm_mounting_constructions/Mounting_base_T-brackets-vertical-rails-connecter.stl

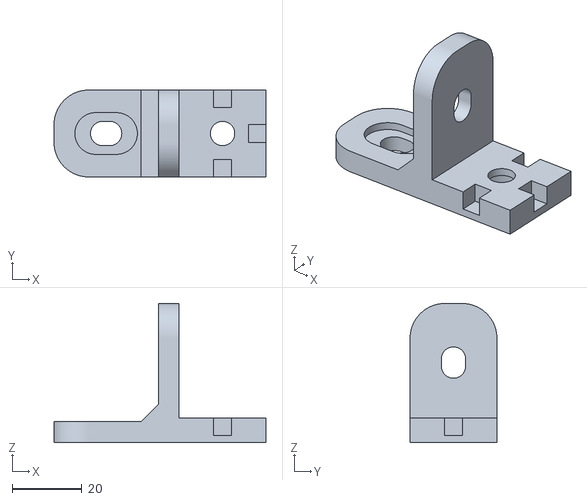
[picture p163: CAD file, 2022-08-08]
docs/assets/src/3D_printed_parts/Enclosure&Powering/25-mm_mounting_constructions/Mounting_base_T-brackets-vertical-rails-connecter.stl
61.0 x 25.0 x 40.0
