shaliulab/idoc_docs/docs/assets/src/3D_printed_parts/Enclosure&Powering/Holes_backside_enclosure/Powering_panels/Top_right_and_left_panel/Ouside_fixation_box_top_powering_panel_part_2_of_3.stl

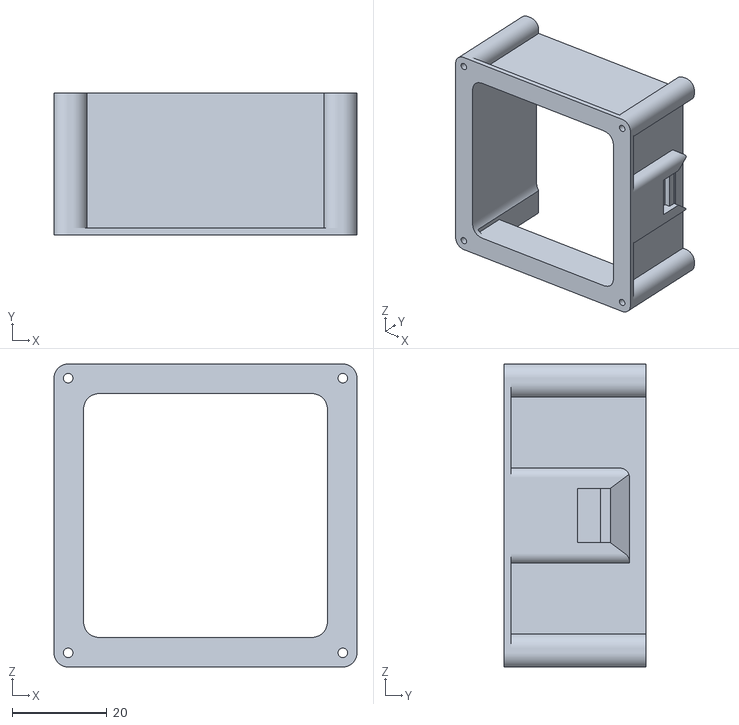
[picture p164: CAD file, 2022-08-08]
docs/assets/src/3D_printed_parts/Enclosure&Powering/Holes_backside_enclosure/Powering_panels/Top_right_and_left_panel/Ouside_fixation_box_top_powering_panel_part_2_of_3.stl
64.0 x 30.0 x 64.0
