shaliulab/idoc_docs/docs/assets/src/3D_printed_parts/Green_light_panel/Green_light_panel - Green_LED_Stencil.stl

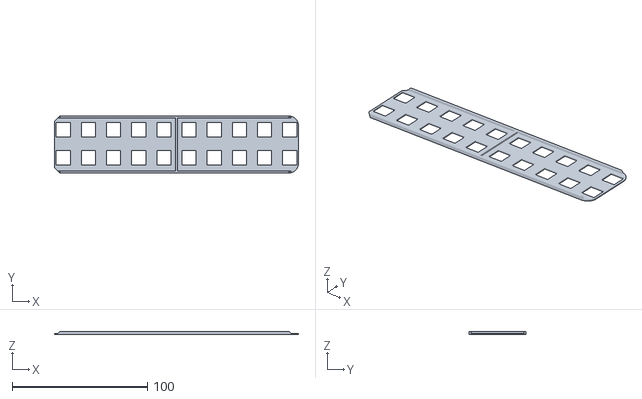
[picture p165: CAD file, 2022-08-08]
docs/assets/src/3D_printed_parts/Green_light_panel/Green_light_panel - Green_LED_Stencil.stl
180.3 x 42.0 x 2.50
