shaliulab/idoc_docs/docs/assets/src/3D_printed_parts/IDOC_setup/007_3D_Corners_connector_bridge_CENTER.stl

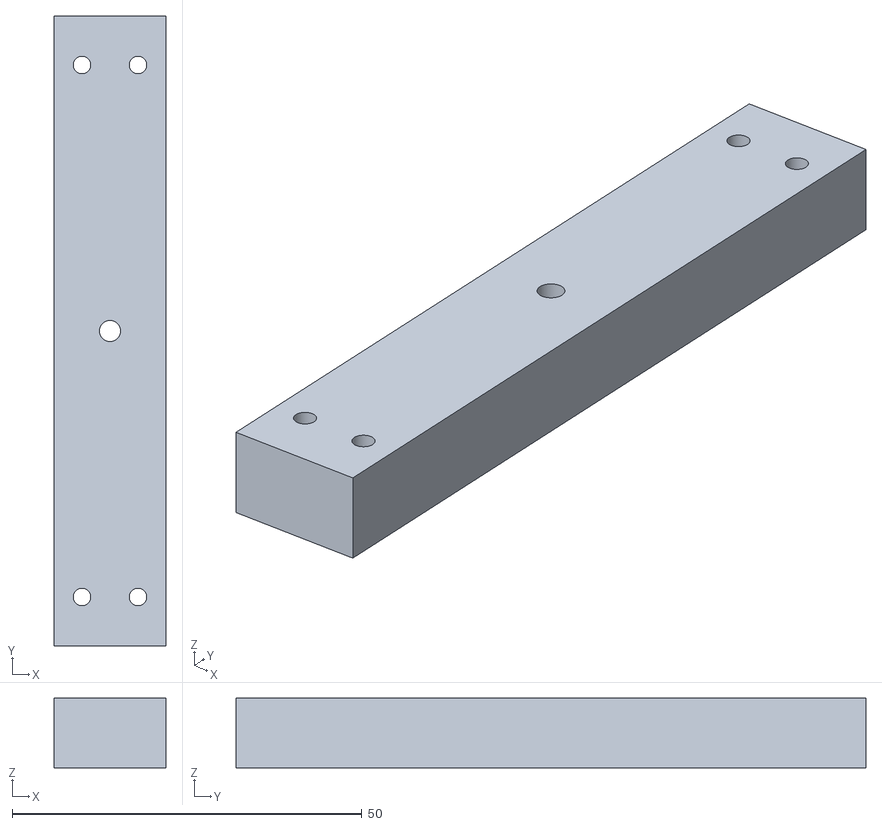
[picture p166: CAD file, 2022-08-08]
docs/assets/src/3D_printed_parts/IDOC_setup/007_3D_Corners_connector_bridge_CENTER.stl
16.0 x 90.0 x 10.0
