shaliulab/idoc_docs/docs/assets/src/3D_printed_parts/Recording_chambers/Chamber_Non_ITO-L_plug.stl

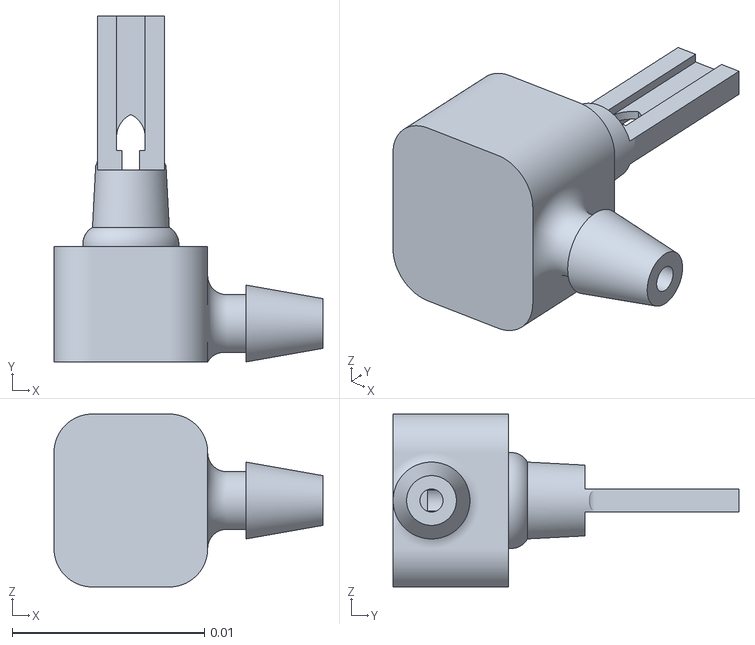
[picture p167: CAD file, 2024-10-31]
docs/assets/src/3D_printed_parts/Recording_chambers/Chamber_Non_ITO-L_plug.stl
0.014 x 0.018 x 0.009
