shaliulab/idoc_docs/docs/assets/src/3D_printed_parts/Green_light_panel/Green_light_panel - Diffuser_holder_wall_LEFT.stl

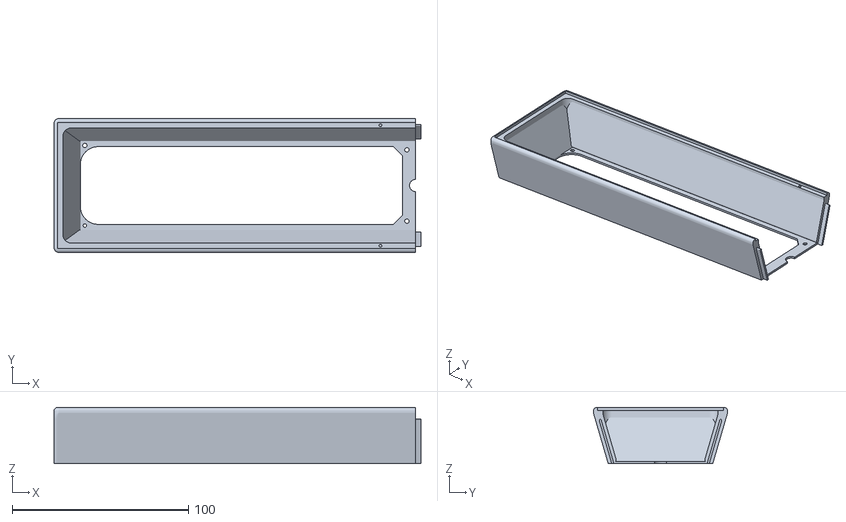
[picture p169: CAD file, 2022-08-08]
docs/assets/src/3D_printed_parts/Green_light_panel/Green_light_panel - Diffuser_holder_wall_LEFT.stl
208.0 x 76.1 x 31.8
