shaliulab/idoc_docs/docs/assets/src/3D_printed_parts/IDOC_setup/073-078_COML_CUST_Difuser_of_indicator_6X_1_of_6.stl

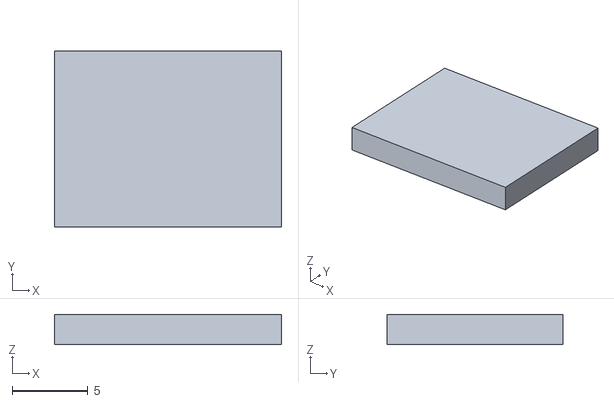
[picture p170: CAD file, 2022-08-08]
docs/assets/src/3D_printed_parts/IDOC_setup/073-078_COML_CUST_Difuser_of_indicator_6X_1_of_6.stl
15.0 x 11.6 x 2.00
