shaliulab/idoc_docs/docs/assets/src/3D_printed_parts/Recording_chambers/Rubber_cut-Mid_rubber_template.stl

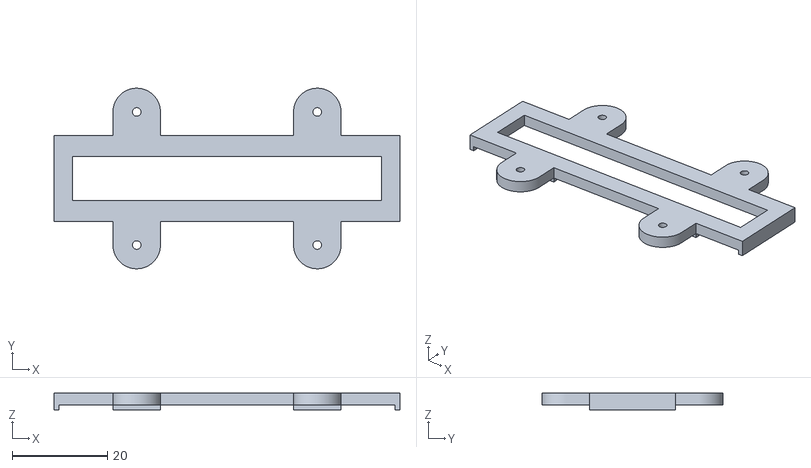
[picture p171: CAD file, 2024-10-31]
docs/assets/src/3D_printed_parts/Recording_chambers/Rubber_cut-Mid_rubber_template.stl
72.8 x 38.0 x 3.50
