shaliulab/idoc_docs/docs/assets/src/3D_printed_parts/Air_inflow_outflow_olfaction_system/Manifold_holder - Vacuum_manifold_holder_2.stl

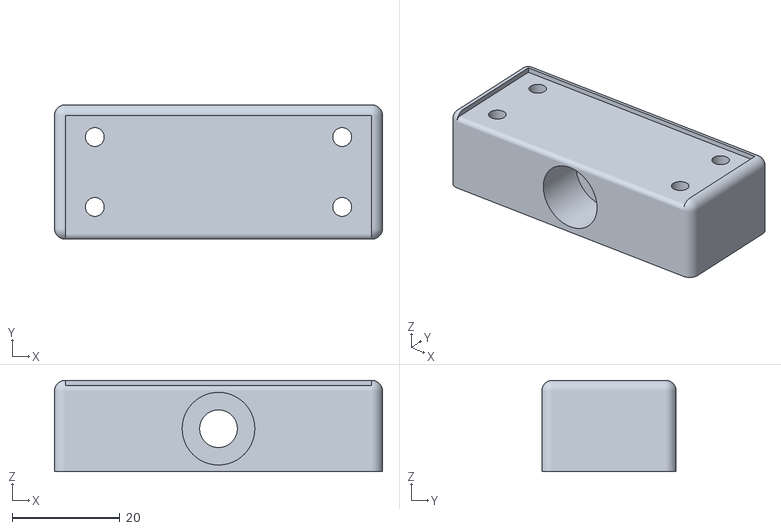
[picture p172: CAD file, 2022-08-08]
docs/assets/src/3D_printed_parts/Air_inflow_outflow_olfaction_system/Manifold_holder - Vacuum_manifold_holder_2.stl
61.0 x 25.0 x 17.0
