shaliulab/idoc_docs/docs/assets/src/3D_printed_parts/Green_light_panel/Green_light_panel - Diffusser.stl

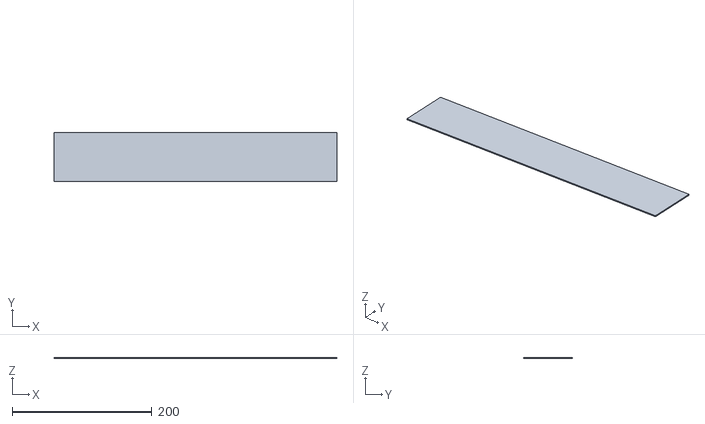
[picture p173: CAD file, 2022-08-08]
docs/assets/src/3D_printed_parts/Green_light_panel/Green_light_panel - Diffusser.stl
405.0 x 70.0 x 1.50
