shaliulab/idoc_docs/docs/assets/src/3D_printed_parts/IDOC_setup/042_3D_Odors_indicator.stl

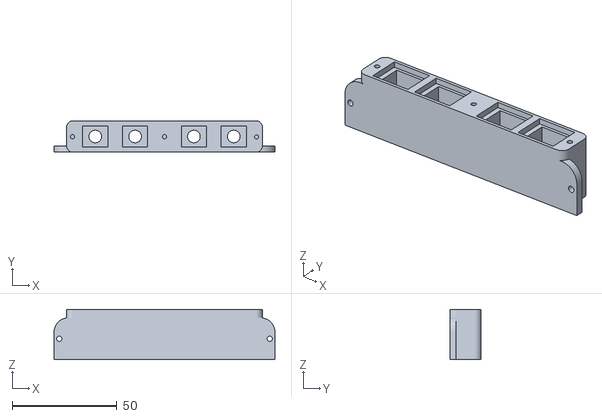
[picture p174: CAD file, 2022-08-08]
docs/assets/src/3D_printed_parts/IDOC_setup/042_3D_Odors_indicator.stl
105.3 x 15.0 x 24.0
