shaliulab/idoc_docs/docs/assets/src/3D_printed_parts/Recording_chambers/Chamber_ITO-Window.stl

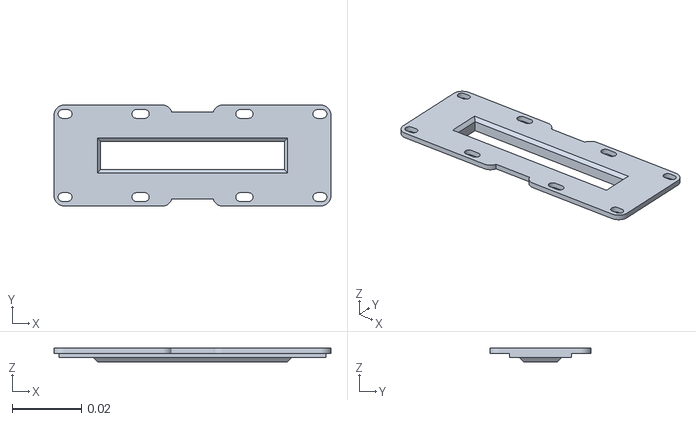
[picture p175: CAD file, 2024-10-31]
docs/assets/src/3D_printed_parts/Recording_chambers/Chamber_ITO-Window.stl
0.08 x 0.0292 x 0.0039
