shaliulab/idoc_docs/docs/assets/src/3D_printed_parts/Air_inflow_outflow_olfaction_system/Flowmeter_holder_single - flowmeter hoder.stl

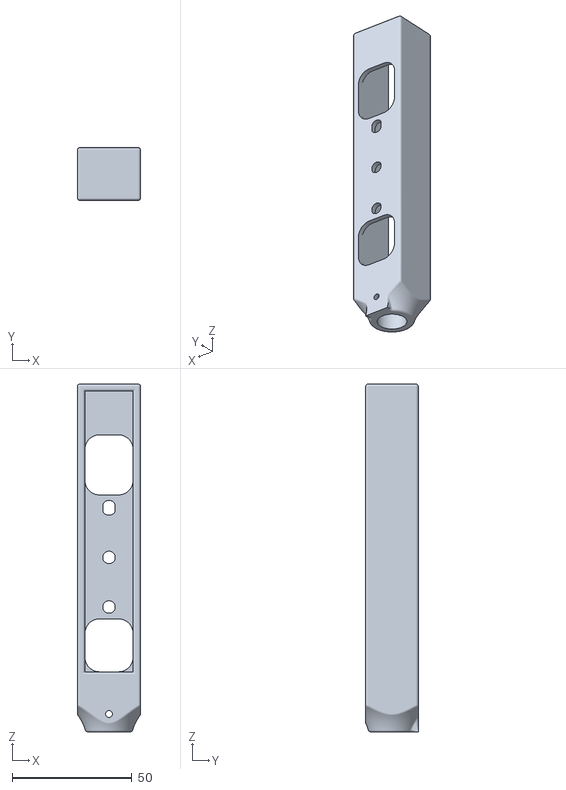
[picture p176: CAD file, 2022-08-08]
docs/assets/src/3D_printed_parts/Air_inflow_outflow_olfaction_system/Flowmeter_holder_single - flowmeter hoder.stl
26.4 x 22.0 x 145.0
