shaliulab/idoc_docs/docs/assets/src/3D_printed_parts/Green_light_panel/Green_light_panel - Diffuser_holder_wall_RIGHT.stl

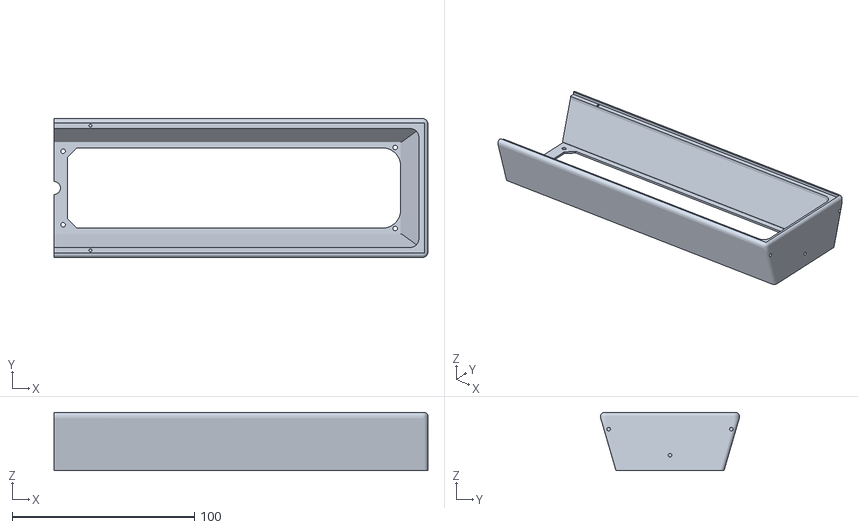
[picture p177: CAD file, 2022-08-08]
docs/assets/src/3D_printed_parts/Green_light_panel/Green_light_panel - Diffuser_holder_wall_RIGHT.stl
205.0 x 76.1 x 31.8
