shaliulab/idoc_docs/docs/assets/src/3D_printed_parts/IDOC_setup/014-3D_Inflow_tubes_collector_BACK_MIDDLE_03B.stl

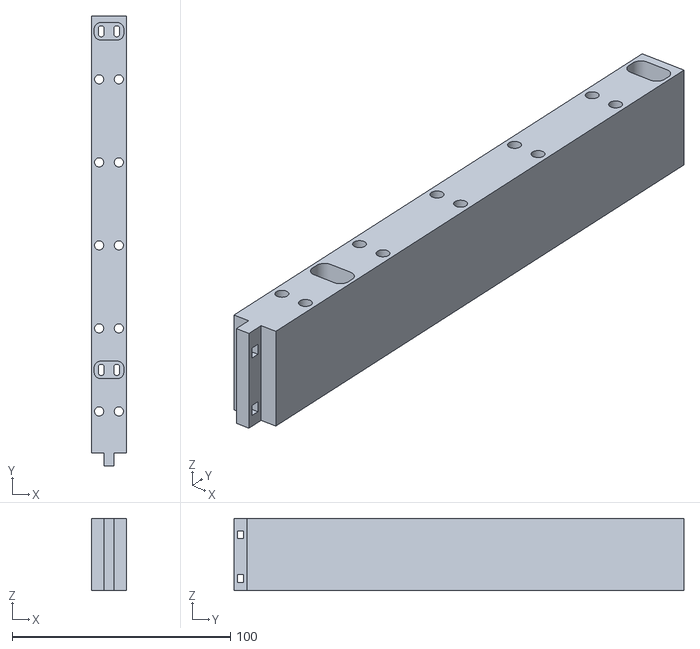
[picture p178: CAD file, 2022-08-08]
docs/assets/src/3D_printed_parts/IDOC_setup/014-3D_Inflow_tubes_collector_BACK_MIDDLE_03B.stl
16.0 x 206.0 x 33.0
