shaliulab/idoc_docs/docs/assets/src/3D_printed_parts/Air_inflow_outflow_olfaction_system/Manifold_holder - Vacuum_manifold.stl

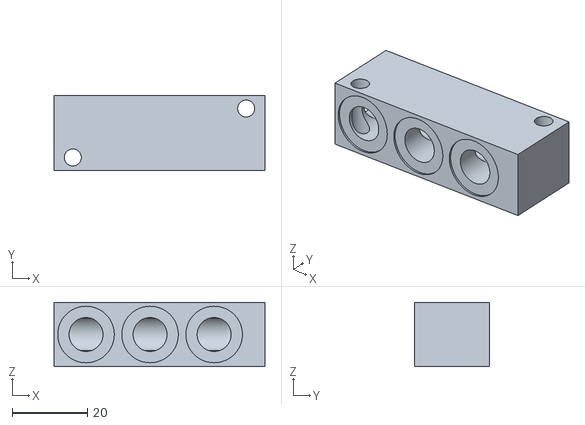
[picture p179: CAD file, 2022-08-08]
docs/assets/src/3D_printed_parts/Air_inflow_outflow_olfaction_system/Manifold_holder - Vacuum_manifold.stl
56.0 x 20.0 x 17.0
