shaliulab/idoc_docs/docs/assets/src/3D_printed_parts/Green_light_panel/Green_light_panel - Cover_holder_wall_RIGHT.stl

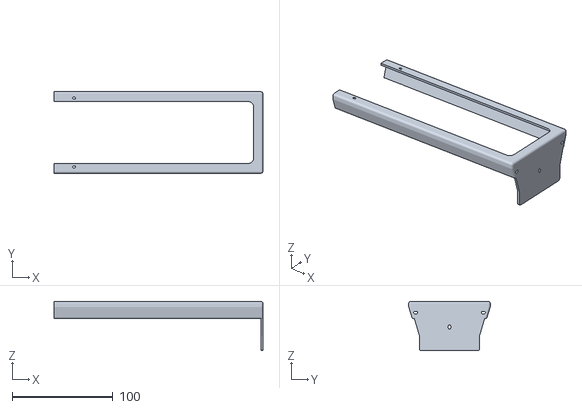
[picture p180: CAD file, 2022-08-08]
docs/assets/src/3D_printed_parts/Green_light_panel/Green_light_panel - Cover_holder_wall_RIGHT.stl
207.4 x 80.9 x 48.8
