shaliulab/idoc_docs/docs/assets/src/3D_printed_parts/IDOC_setup/008_3D_Corners_connector_bridge_BACK.stl

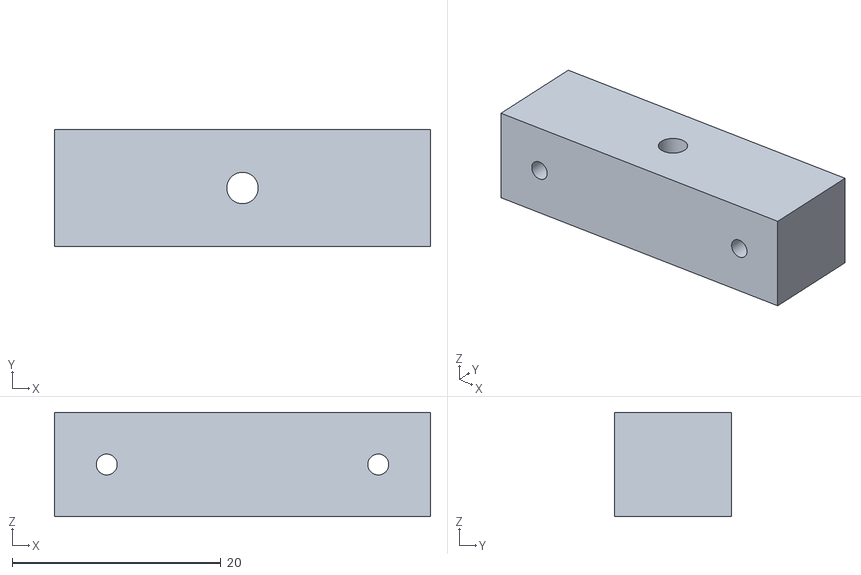
[picture p181: CAD file, 2022-08-08]
docs/assets/src/3D_printed_parts/IDOC_setup/008_3D_Corners_connector_bridge_BACK.stl
36.0 x 11.2 x 10.0
