shaliulab/idoc_docs/docs/assets/src/3D_printed_parts/Recording_chambers/Rubber_cut-Bot-rubber-template.stl

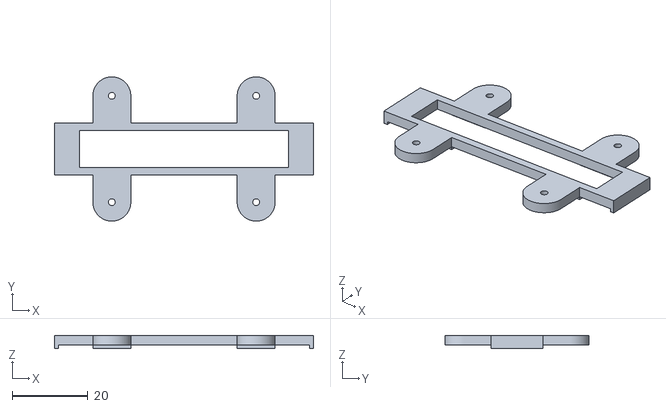
[picture p182: CAD file, 2024-10-31]
docs/assets/src/3D_printed_parts/Recording_chambers/Rubber_cut-Bot-rubber-template.stl
68.2 x 38.0 x 3.30
