shaliulab/idoc_docs/docs/assets/src/3D_printed_parts/Air_inflow_outflow_olfaction_system/Manifold_holder - Manifold_holder.stl

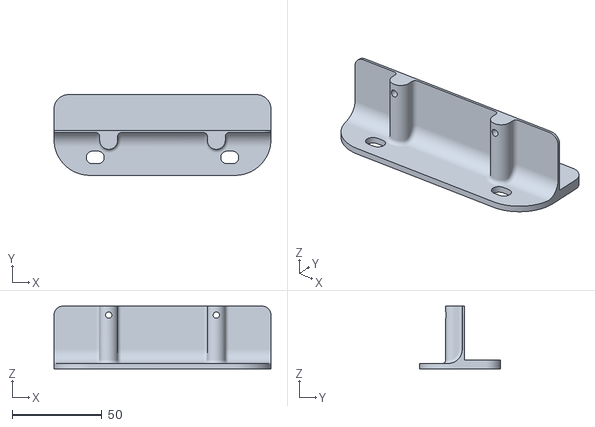
[picture p183: CAD file, 2022-08-08]
docs/assets/src/3D_printed_parts/Air_inflow_outflow_olfaction_system/Manifold_holder - Manifold_holder.stl
121.0 x 45.0 x 35.0
