shaliulab/idoc_docs/docs/assets/src/3D_printed_parts/IDOC_setup/083-IR_filter_holder_splitter_FRONT.stl

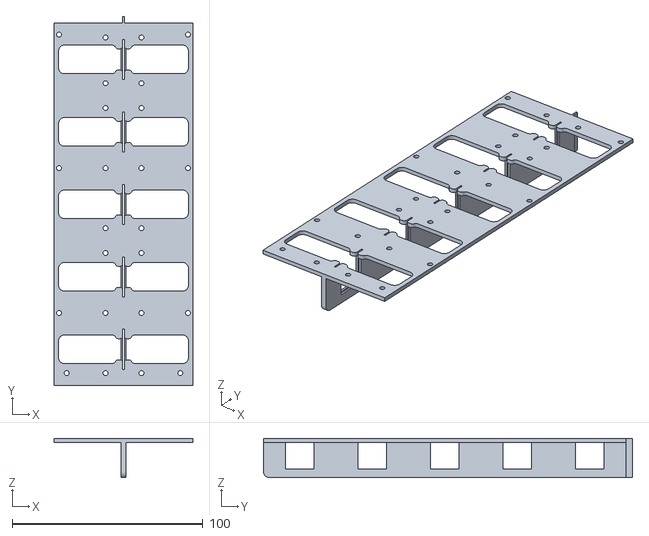
[picture p184: CAD file, 2022-08-08]
docs/assets/src/3D_printed_parts/IDOC_setup/083-IR_filter_holder_splitter_FRONT.stl
72.8 x 193.5 x 20.5
