shaliulab/idoc_docs/docs/assets/src/3D_printed_parts/Recording_chambers/Rubber_cut-Top_rubber_template.stl

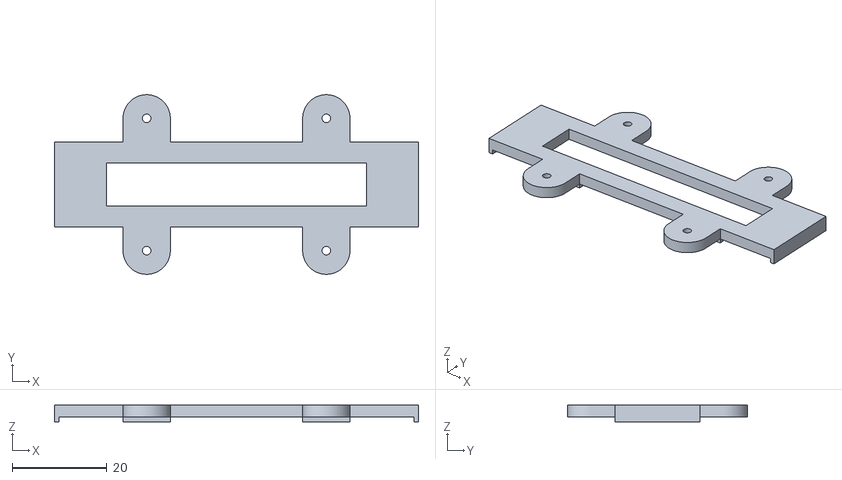
[picture p185: CAD file, 2024-10-31]
docs/assets/src/3D_printed_parts/Recording_chambers/Rubber_cut-Top_rubber_template.stl
77.0 x 38.0 x 3.50
