shaliulab/idoc_docs/docs/assets/src/3D_printed_parts/IDOC_setup/019-3D_Heatsink_connectors_04_of_04.stl

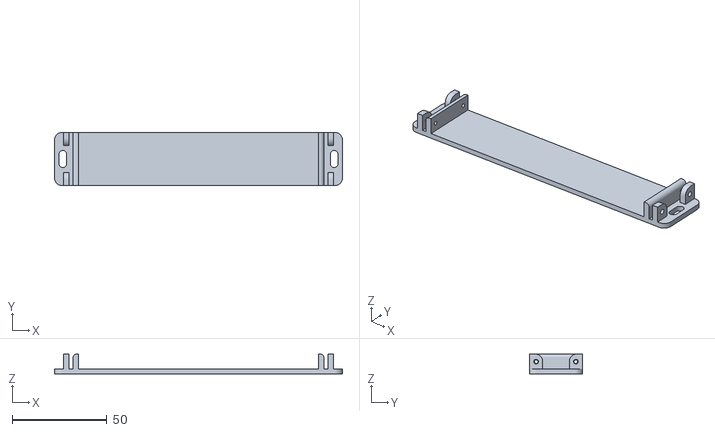
[picture p186: CAD file, 2022-08-08]
docs/assets/src/3D_printed_parts/IDOC_setup/019-3D_Heatsink_connectors_04_of_04.stl
152.0 x 28.0 x 10.5
