shaliulab/idoc_docs/docs/assets/src/3D_printed_parts/Air_inflow_outflow_olfaction_system/Manifold_holder 2 - Manifold_holder.stl

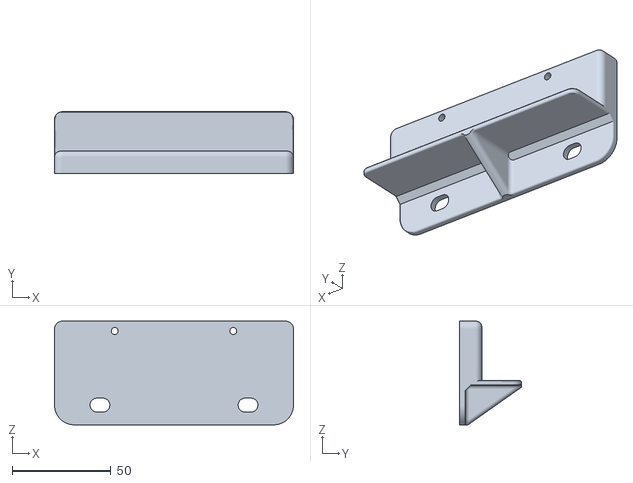
[picture p187: CAD file, 2022-08-08]
docs/assets/src/3D_printed_parts/Air_inflow_outflow_olfaction_system/Manifold_holder 2 - Manifold_holder.stl
121.0 x 31.2 x 52.5
