shaliulab/idoc_docs/docs/assets/src/3D_printed_parts/IDOC_setup/045_3D_EShock_LED_indicator_cover.stl

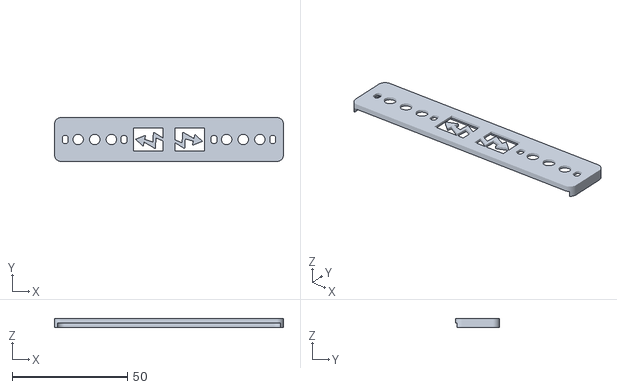
[picture p188: CAD file, 2022-08-08]
docs/assets/src/3D_printed_parts/IDOC_setup/045_3D_EShock_LED_indicator_cover.stl
99.3 x 19.0 x 4.00
