shaliulab/idoc_docs/docs/assets/src/3D_printed_parts/IDOC_setup/038B-041B_3D_Target_cover_white_part_4X_1_of_4.stl

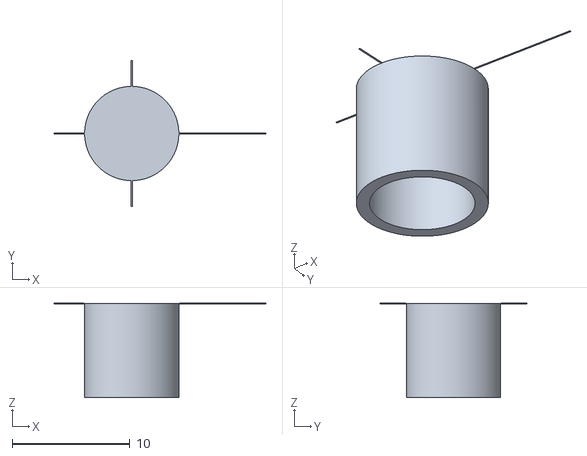
[picture p189: CAD file, 2022-08-08]
docs/assets/src/3D_printed_parts/IDOC_setup/038B-041B_3D_Target_cover_white_part_4X_1_of_4.stl
18.0 x 12.4 x 8.00
