shaliulab/idoc_docs/docs/assets/src/3D_printed_parts/IDOC_setup/026-029_3D_light_box_heatsink_connector_4x_01_of_04.stl

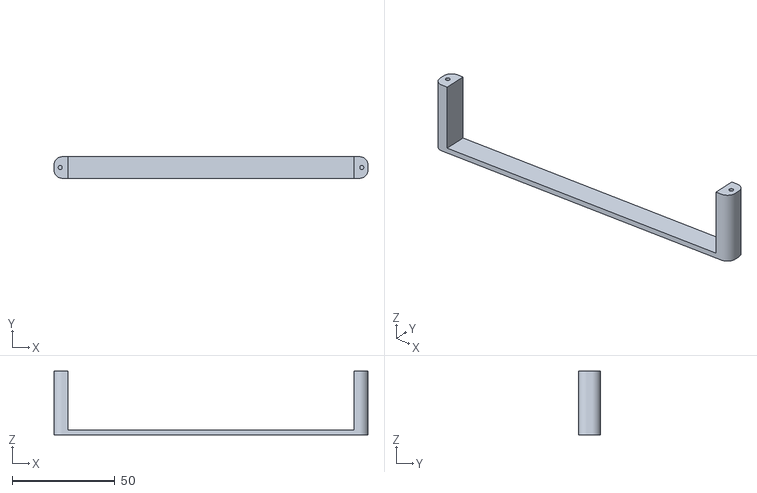
[picture p190: CAD file, 2022-08-08]
docs/assets/src/3D_printed_parts/IDOC_setup/026-029_3D_light_box_heatsink_connector_4x_01_of_04.stl
152.5 x 10.5 x 31.0
