shaliulab/idoc_docs/docs/assets/src/3D_printed_parts/IDOC_setup/089-Stencil_LEDs.stl

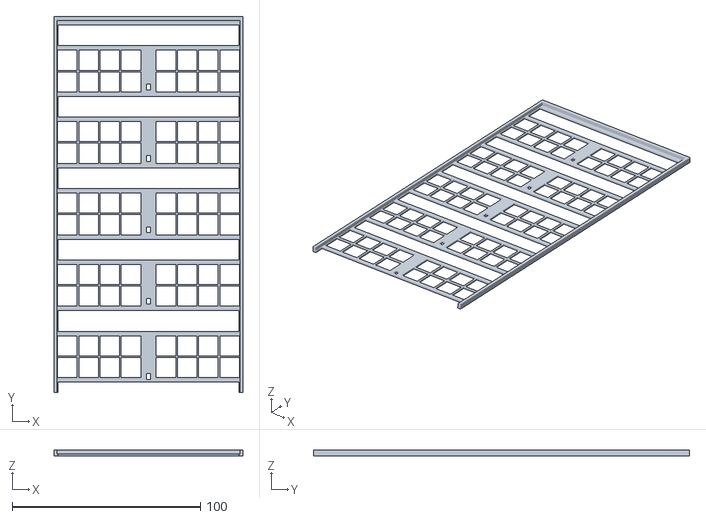
[picture p191: CAD file, 2022-08-08]
docs/assets/src/3D_printed_parts/IDOC_setup/089-Stencil_LEDs.stl
100.5 x 200.0 x 3.00
