shaliulab/idoc_docs/docs/assets/src/3D_printed_parts/IDOC_setup/088-Front_side_wall.stl

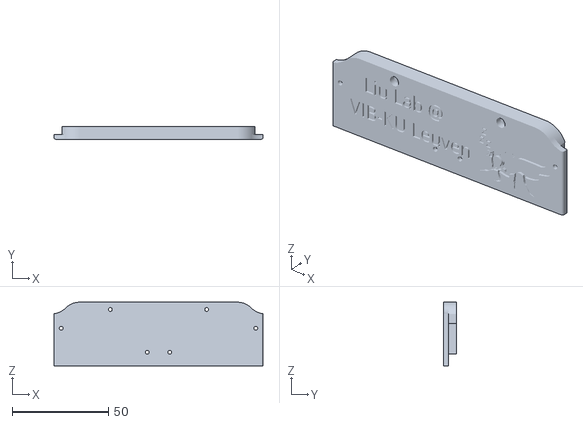
[picture p192: CAD file, 2022-08-08]
docs/assets/src/3D_printed_parts/IDOC_setup/088-Front_side_wall.stl
108.4 x 6.50 x 33.0
