shaliulab/idoc_docs/docs/assets/src/3D_printed_parts/IDOC_setup/085-White_light_box_BACK.stl

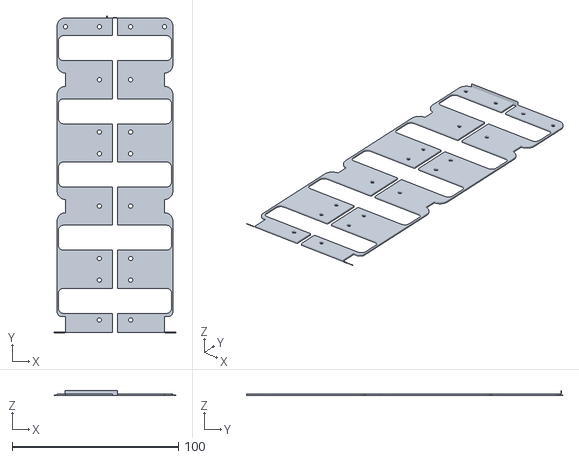
[picture p193: CAD file, 2022-08-08]
docs/assets/src/3D_printed_parts/IDOC_setup/085-White_light_box_BACK.stl
72.8 x 190.0 x 3.00
