shaliulab/idoc_docs/docs/assets/src/3D_printed_parts/IDOC_setup/090-EShock_cover_Chamber_holder_boarder_slider_BACK.stl

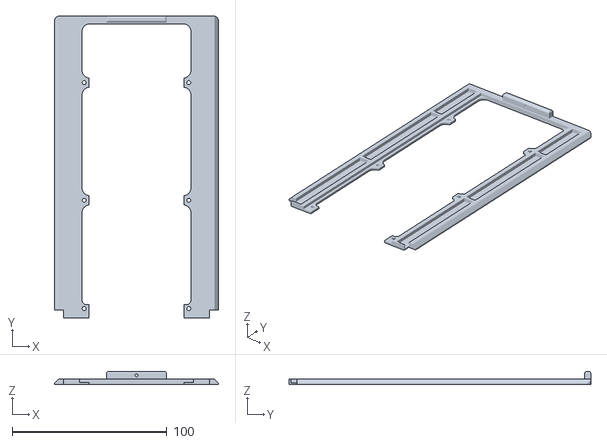
[picture p194: CAD file, 2022-08-08]
docs/assets/src/3D_printed_parts/IDOC_setup/090-EShock_cover_Chamber_holder_boarder_slider_BACK.stl
106.0 x 195.0 x 8.50
