shaliulab/idoc_docs/docs/assets/src/3D_printed_parts/IDOC_setup/033_Light_box_RIGHT_FRONT_04.stl

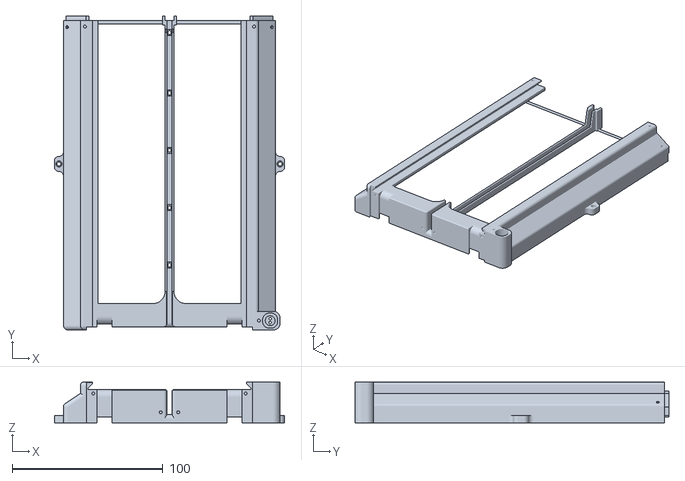
[picture p195: CAD file, 2022-08-08]
docs/assets/src/3D_printed_parts/IDOC_setup/033_Light_box_RIGHT_FRONT_04.stl
152.5 x 208.0 x 27.0
