shaliulab/idoc_docs/docs/assets/src/3D_printed_parts/IDOC_setup/043_3D_Odors_indicator_cover.stl

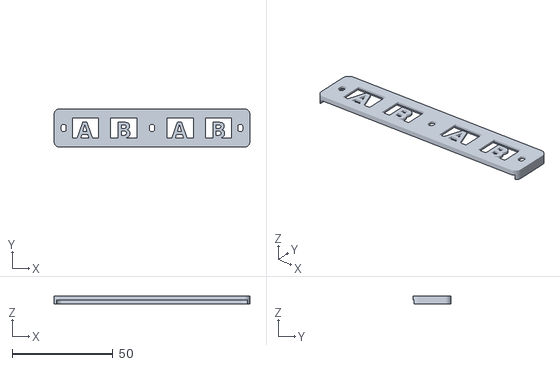
[picture p197: CAD file, 2022-08-08]
docs/assets/src/3D_printed_parts/IDOC_setup/043_3D_Odors_indicator_cover.stl
97.3 x 19.0 x 4.00
