shaliulab/idoc_docs/docs/assets/src/3D_printed_parts/IDOC_setup/067-072_COML_3-mm_IR_LED_6X_1_of_6.stl

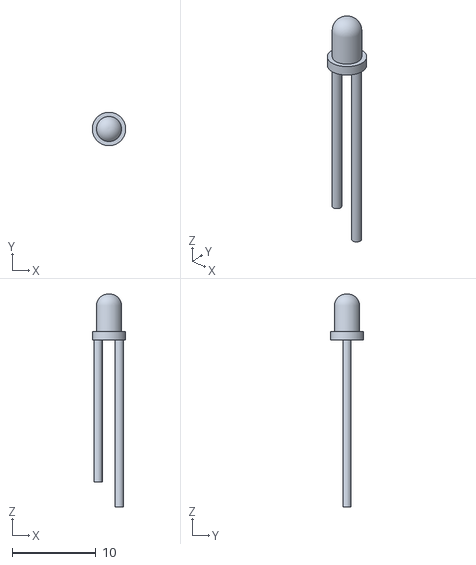
[picture p199: CAD file, 2022-08-08]
docs/assets/src/3D_printed_parts/IDOC_setup/067-072_COML_3-mm_IR_LED_6X_1_of_6.stl
4.00 x 4.00 x 25.5
