shaliulab/idoc_docs/docs/assets/src/3D_printed_parts/IDOC_setup/091-EShock_cover_Chamber_holder_boarder_slider_FRONT.stl

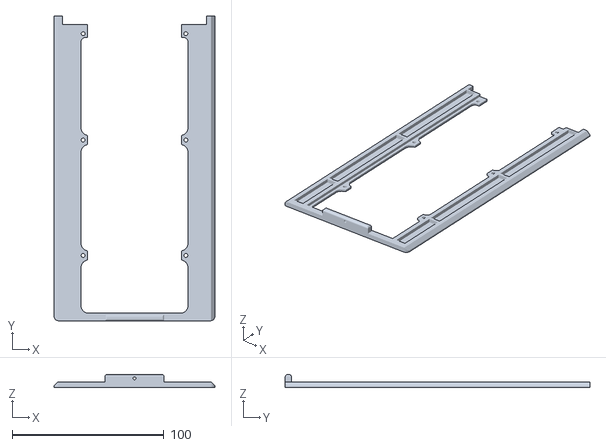
[picture p200: CAD file, 2022-08-08]
docs/assets/src/3D_printed_parts/IDOC_setup/091-EShock_cover_Chamber_holder_boarder_slider_FRONT.stl
106.0 x 200.5 x 8.50
