shaliulab/idoc_docs/docs/assets/src/3D_printed_parts/IDOC_setup/034_3D_light_box_connector_bridge_4X_01_of_04.stl

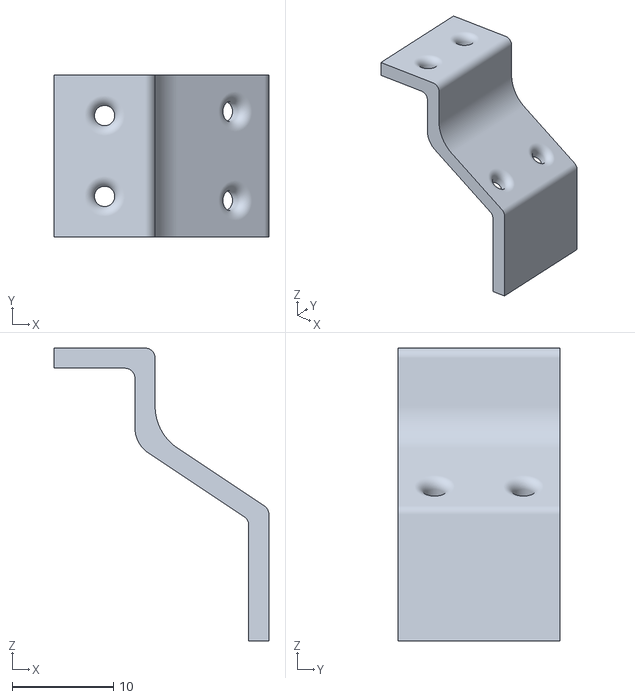
[picture p201: CAD file, 2022-08-08]
docs/assets/src/3D_printed_parts/IDOC_setup/034_3D_light_box_connector_bridge_4X_01_of_04.stl
21.3 x 16.0 x 29.0
