shaliulab/idoc_docs/docs/assets/src/3D_printed_parts/IDOC_setup/087-Diffuser_holder.stl

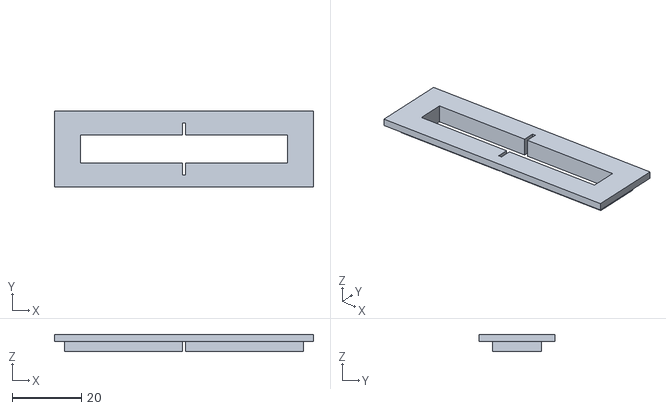
[picture p202: CAD file, 2022-08-08]
docs/assets/src/3D_printed_parts/IDOC_setup/087-Diffuser_holder.stl
75.0 x 22.0 x 5.00
