shaliulab/idoc_docs/docs/assets/src/3D_printed_parts/IDOC_setup/022_COML_CUST_Alum._angle_profile_4X_01_of_04.stl

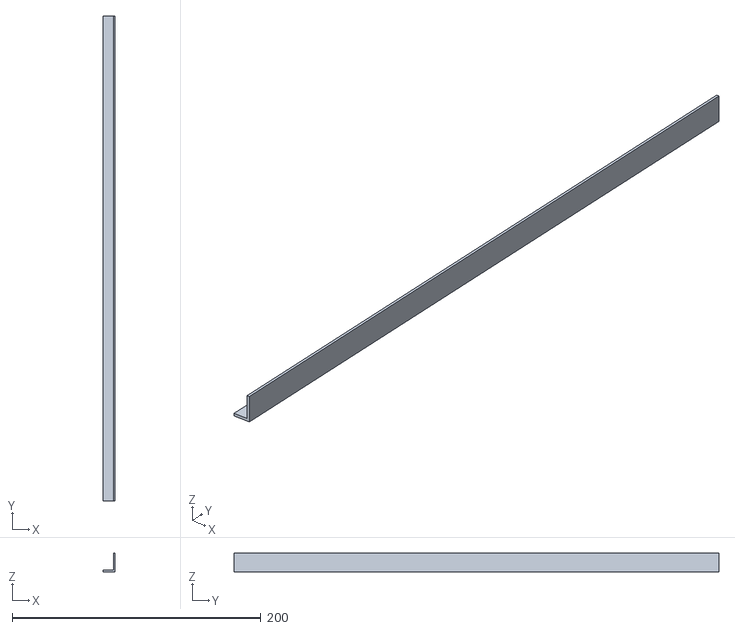
[picture p203: CAD file, 2022-08-08]
docs/assets/src/3D_printed_parts/IDOC_setup/022_COML_CUST_Alum._angle_profile_4X_01_of_04.stl
10.0 x 390.0 x 15.0
