shaliulab/idoc_docs/docs/assets/src/3D_printed_parts/IDOC_setup/013-3D_Inflow_tubes_collector_FRONT_MIDDLE_03A.stl

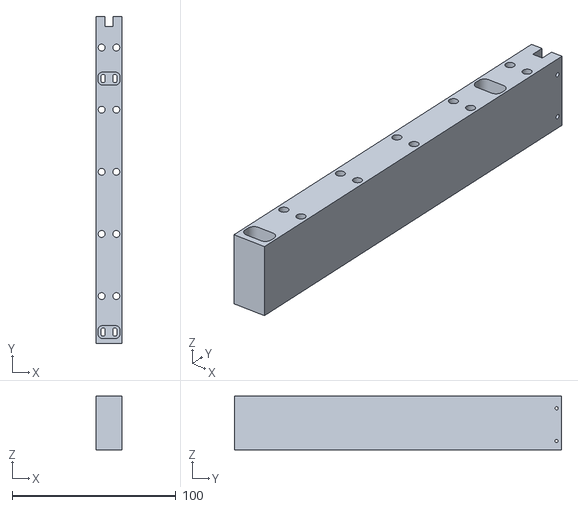
[picture p204: CAD file, 2022-08-08]
docs/assets/src/3D_printed_parts/IDOC_setup/013-3D_Inflow_tubes_collector_FRONT_MIDDLE_03A.stl
16.0 x 200.0 x 33.0
