shaliulab/idoc_docs/docs/assets/src/3D_printed_parts/IDOC_setup/005-3D_Wiring_Powering_connection_holder_04B.stl

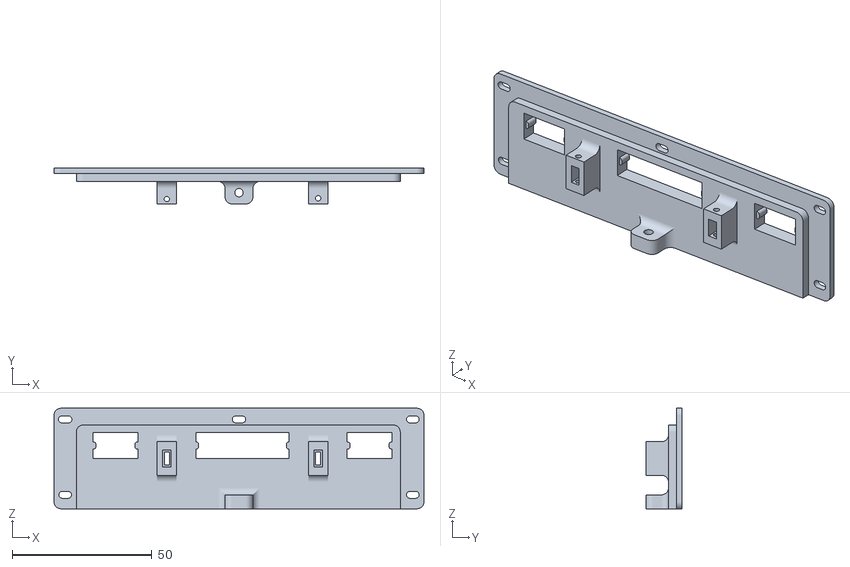
[picture p205: CAD file, 2022-08-08]
docs/assets/src/3D_printed_parts/IDOC_setup/005-3D_Wiring_Powering_connection_holder_04B.stl
132.5 x 12.8 x 36.0
