shaliulab/idoc_docs/docs/assets/src/3D_printed_parts/IDOC_setup/052-057_3D_Holder_of_3-mm_LED_6X_1_of_6.stl

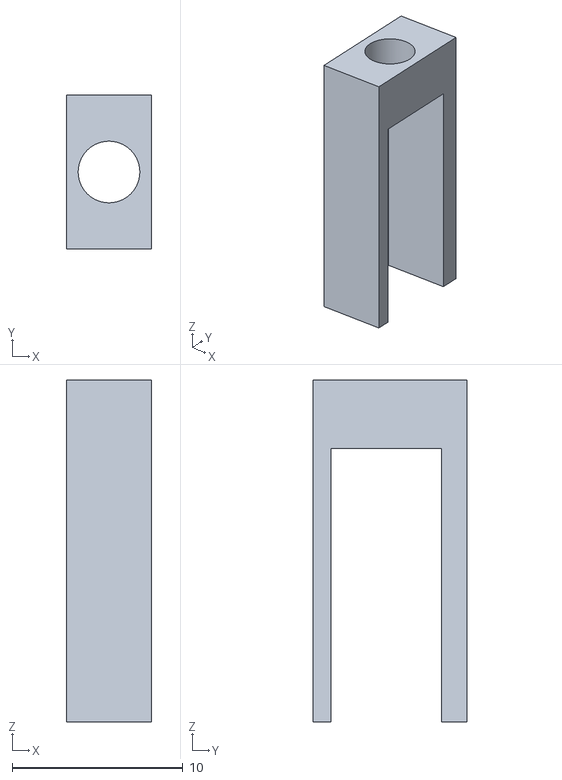
[picture p206: CAD file, 2022-08-08]
docs/assets/src/3D_printed_parts/IDOC_setup/052-057_3D_Holder_of_3-mm_LED_6X_1_of_6.stl
5.00 x 9.00 x 20.0
