shaliulab/idoc_docs/docs/assets/src/3D_printed_parts/IDOC_setup/046-051_5mm_LED_indcator_holder_6X_1_of_6.stl

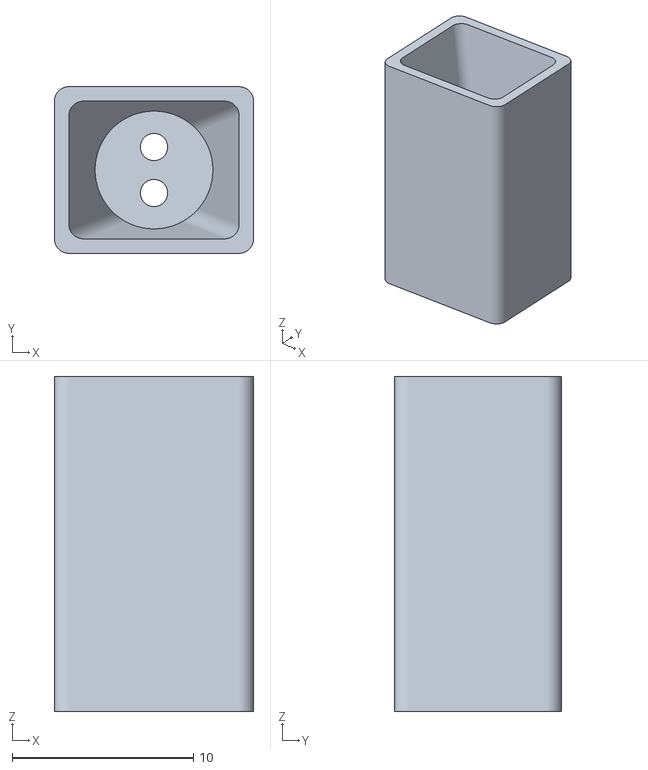
[picture p207: CAD file, 2022-08-08]
docs/assets/src/3D_printed_parts/IDOC_setup/046-051_5mm_LED_indcator_holder_6X_1_of_6.stl
11.0 x 9.20 x 18.5
