shaliulab/idoc_docs/docs/assets/src/3D_printed_parts/IDOC_setup/009-3D_Inflow_tubes_collector_BACK_LEFT_01A.stl

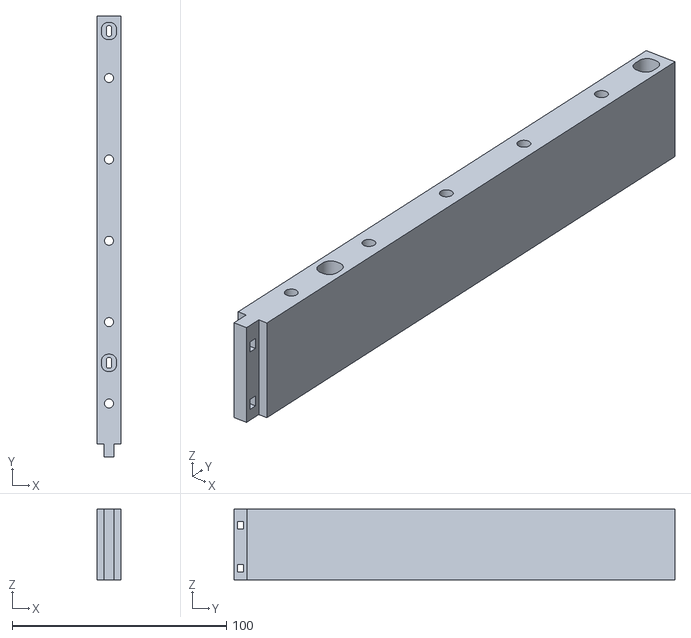
[picture p208: CAD file, 2022-08-08]
docs/assets/src/3D_printed_parts/IDOC_setup/009-3D_Inflow_tubes_collector_BACK_LEFT_01A.stl
11.0 x 206.0 x 33.0
