shaliulab/idoc_docs/docs/assets/src/3D_printed_parts/IDOC_setup/058_066_COML_IR_LED_5-mm_9X_1_of_9.stl

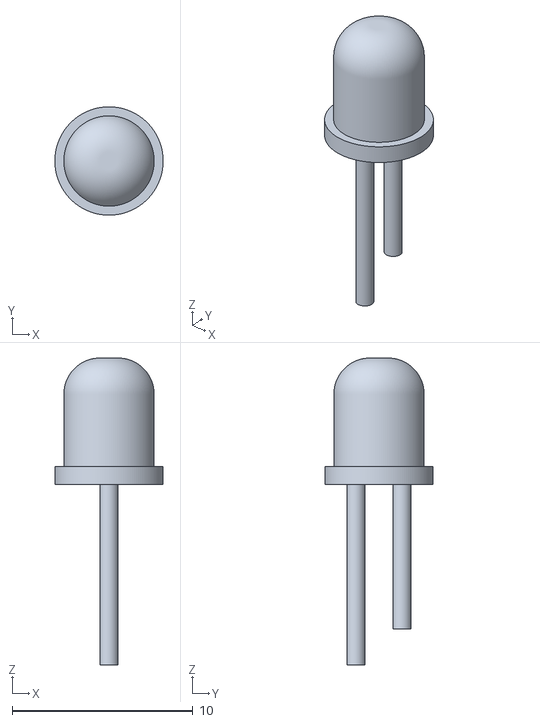
[picture p209: CAD file, 2022-08-08]
docs/assets/src/3D_printed_parts/IDOC_setup/058_066_COML_IR_LED_5-mm_9X_1_of_9.stl
6.00 x 6.00 x 17.0
