shaliulab/idoc_docs/docs/assets/src/3D_printed_parts/IDOC_setup/082-Air_Vent_Heatsink.stl

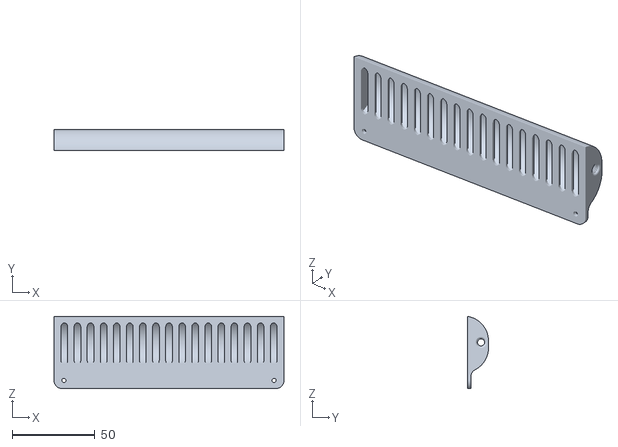
[picture p210: CAD file, 2022-08-08]
docs/assets/src/3D_printed_parts/IDOC_setup/082-Air_Vent_Heatsink.stl
138.9 x 12.7 x 43.6
