shaliulab/idoc_docs/(list of files, cad)

Other CAD files:
docs/assets/src/3D_printed_parts/Enclosure&Powering/Holes_backside_enclosure/Powering_panels/Bottom_right_panel/IDC_connector_RED_BLUE_LEDs+setup_RIGHT_powering_panel_part_1_of_3.stl
docs/assets/src/3D_printed_parts/IDOC_setup/017-3D_Heatsink_connectors_02_of_04.stl
docs/assets/src/3D_printed_parts/IDOC_setup/012-3D_Inflow_tubes_collector_FRONT_RIGHT_02B.stl
docs/assets/src/3D_printed_parts/IDOC_setup/006_3D_Corners_conector_bridge_FRONT.stl
docs/assets/src/3D_printed_parts/IDOC_setup/016-3D_Heatsink_connectors_01_of_04.stl
docs/assets/src/3D_printed_parts/IDOC_setup/084-IR_filter_holder_splitter_BACK.stl
docs/assets/src/3D_printed_parts/IDOC_setup/018-3D_Heatsink_connectors_03_of_04.stl
docs/assets/src/3D_printed_parts/IDOC_setup/036_3D_light_box_connector_bridge_4X_03_of_04.stl
docs/assets/src/3D_printed_parts/IDOC_setup/025_COML_CUST_Alum._angle_profile_4X_04_of_04.stl
docs/assets/src/3D_printed_parts/IDOC_setup/024_COML_CUST_Alum._angle_profile_4X_03_of_04.stl
docs/assets/src/3D_printed_parts/IDOC_setup/035_3D_light_box_connector_bridge_4X_02_of_04.stl
docs/assets/src/3D_printed_parts/IDOC_setup/086-White_light_box_FRONT.stl
docs/assets/src/3D_printed_parts/IDOC_setup/023_COML_CUST_Alum._angle_profile_4X_02_of_04.stl
docs/assets/src/3D_printed_parts/IDOC_setup/037_3D_light_box_connector_bridge_4X_04_of_04.stl
docs/assets/src/3D_printed_parts/IDOC_setup/011-3D_Inflow_tubes_collector_BACK_RIGHT_02A.stl
docs/assets/src/3D_printed_parts/IDOC_setup/032_3D_Light_box_RIGHT_BACK_03.stl
docs/assets/src/3D_printed_parts/IDOC_setup/031_3D_Light_box_LEFT_FRON_02.stl
docs/assets/src/3D_printed_parts/Enclosure&Powering/Holes_backside_enclosure/Tubing_hole/Open_screw_thread_neck_size_GL45_tubing_insertion_part_1of_2.stl
docs/assets/src/3D_printed_parts/Enclosure&Powering/Holes_backside_enclosure/Tubing_hole/Open_topped_screw_cap_size_GL45_tubing_insertion_part_2_of_2.stl
docs/assets/src/3D_printed_parts/IDOC_setup/020_Digikey_CUST_345-1936-ND_Heatsink_RIGHT.stl
docs/assets/src/3D_printed_parts/IDOC_setup/021_Digikey_CUST_345-1936-ND_Heatsink_LEFT.stl
