shaliulab/idoc_docs/(commit log)

2023-10-04 moved chamber image to correct spot
2023-10-04 cleaned chamber assembly section
2023-10-04 further cleaning of assembly section
2023-10-04 Cleaned up 3D assembly section
2023-10-30 Moved chamber things to relevant section and cleaned
2023-11-06 Start cleaning enclosure sections
2023-11-16 Update breadboard enclosure
2023-11-17 Update docs
    [List-of-Commercial-Parts-Tools.csv]
2024-02-02 Add guide for ITO chamber assembly and made normal chamber info format more consistent
2024-02-08 Add images of ITO chamber construction
2024-02-08 Fix chamber assembly
2024-02-08 Fix tbale in camera enclosure
2024-02-08 Fix typos, improve installation, add onshape assembly image
    [mega.csv, warm_up.csv]
2024-10-31 Add IDOC ITO chamber body STL file
2024-10-31 Add IDOC ITO chamber top STL file
    [Chamber_ ITO_top.stl]
2024-10-31 Add IDOC non-ITO chamber parts
    [Chamber_ Non-ITO_top.stl]
2024-10-31 Add IDOC chamber inner frame and L plug STL files
    [chamber_L-plug.stl, inner_chamber.stl]
2024-10-31 Add rubber cutting templates
    [rubber_cutting_base.stl, template_bottom_rubber.stl, template_middle_rubber.stl, template_top_rubber.stl]
2024-11-06 Update chamber sketch
2024-11-06 Update odor delivery schematic
2024-11-06 Add new odor delivery schematic
2024-11-06 Add more explanation to the odor delivery schematic
2025-08-29 Add page for cleaning info and section for laser cutting
